arammaki/everflo_remote_control/test/everflo-sweep-2026-11-04-tak/bild_4L_2026-11-04T14-48-00.jpg

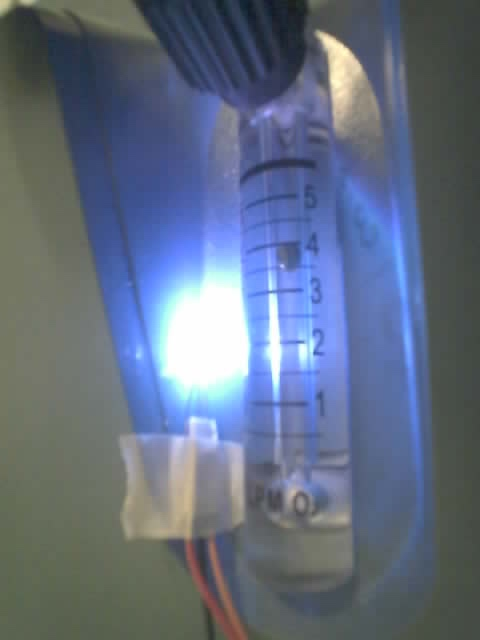
test/everflo-sweep-2026-11-04-tak/bild_4L_2026-11-04T14-48-00.jpg
