arammaki/everflo_remote_control/test/everflo-sweep-2026-11-04-dag/bild_5L_2026-11-04T14-58-03.jpg

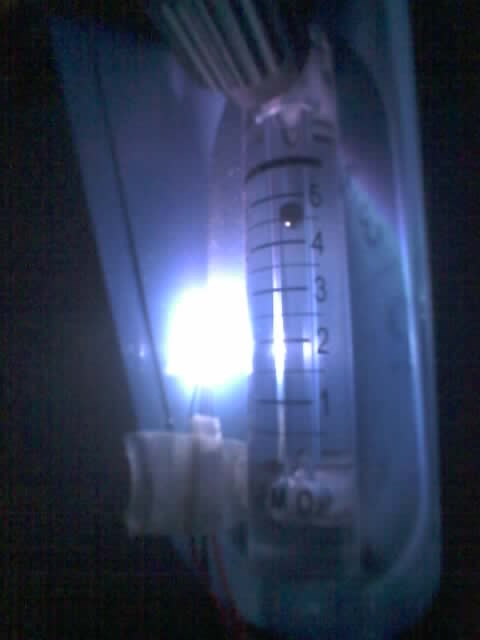
test/everflo-sweep-2026-11-04-dag/bild_5L_2026-11-04T14-58-03.jpg
