arammaki/everflo_remote_control/test/README.md

# Test images

Sets checked in opposite directions — a sweep must read, an old pose must be
refused. All run through the same harness so the two directions cannot drift apart:

```sh
node tools/validate_engine.mjs test/everflo-sweep-2026-10-05-hall
node tools/validate_engine.mjs test/everflo-sweep-2026-10-05-natt
node tools/validate_engine.mjs test/everflo-sweep-2026-10-05-rum
node tools/validate_engine.mjs test/everflo-sweep-2026-10-18-ljus
node tools/validate_engine.mjs test/everflo-sweep-2026-10-18-natt
node tools/validate_engine.mjs test/everflo-sweep-2026-10-18-ljus2
node tools/validate_engine.mjs test/everflo-sweep-2026-10-19-ljus
node tools/validate_engine.mjs test/everflo-sweep-2026-10-19-natt
node tools/validate_engine.mjs test/negative-everflo-2026-08-22 --expect-rejected
node tools/validate_engine.mjs test/negative-old-poses --expect-rejected
node tools/validate_engine.mjs test/platinum9-sweep-2026-09-30b
node tools/validate_engine.mjs test/platinum9-sweep-2026-09-30b-natt
node tools/validate_engine.mjs test/negative-platinum9-2026-09-30 --expect-rejected
node tools/validate_engine.mjs test/negative-platinum9-2026-09-29 --expect-rejected
node tools/validate_engine.mjs test/platinum9-kitchen-2026-09-29
node tools/validate_engine.mjs test/negative-platinum9-2026-09-26 --expect-rejected
```

Every directory carries a `PRESET` file naming the concentrator its frames
are of (`everflo` or `platinum9`). The harness reads it and refuses to
run without one: a sweep scored against the wrong machine's calibration is
refused wholesale, which looks exactly like an engine that has broken. A new
machine's sweep goes in its own directory with its own `PRESET`.

## `everflo-sweep-2026-10-05-hall/` — the care home's EverFlo calibration (history since 1.18.0)

13 frames, 2026-10-05 15:51–15:53 UTC, the EverFlo back on the unit with the
camera much closer to the tube than in the kitchen, the hall lamp on: the
resting ball, 0.5 to 5 in halves (read straight on), the top thick line
(`max`, reads 5.83 as a number) and one past it (`over_max`, must say Max).
`REF_PNG_EVERFLO_HALL`, the bands, `BASE_TILT` and `CAL` come from these;
`GEOMETRY.json` is the geometry they were measured with (calibrate.mjs
`--geometry`). Mean 0.012 L/min, worst 0.029; ambiguity 4.6x at worst (the
over-scale frame), registration 0.98.

## `everflo-sweep-2026-10-05-natt/` — the same pose in the dark

13 frames five minutes later, lamps off and curtains drawn: the 'natt'
reference. Not fitted to — the curve is the hall sweep's — so it checks the
curve independently: mean 0.016, worst 0.041. `over_max` is refused here
(ambiguity 2.5x) instead of called Max, listed in `ALLOW_REFUSED`.

## `everflo-sweep-2026-10-05-rum/` — the same pose, the room lamp on

13 frames at 16:01–16:03 UTC, hall lamp off, room lamp on: the 'rum'
reference. Not fitted to either: mean 0.024, worst 0.049, `over_max` says Max.

## `everflo-sweep-2026-10-18-ljus/` and `-natt/` — the camera's next pose

Taken by someone on site after the camera had moved ~11 px: the 'ljus' and
'natt2' references, aligned into the 10-05 coordinates ('ljus' dropped in
1.14.6; the light sweeps now read through ljus3). Not fitted to. The
bottom and top labels were corrected with the operator ("0" is 0.5, "0.5" is
0.75, "Övre max" a second max) — see each `LABELS.md`. No resting ball and no
ball past the top line in either. ljus mean 0.020 worst 0.046 (0.026 with 'ljus'); natt mean
0.025 worst 0.062.

## `everflo-sweep-2026-11-06-hagtorp-dag/` and `-mork/` — the EverFlo at Hagtorp (1.18.2-1.18.3)

Daylight with the lamps on, and lamps off with the blind down; they build
'hagtorp' and 'hagmork' on the Norrgården curve, both shifted (-3, +4) onto
'tak': means 0.041 and 0.056, worst 0.10 and 0.12. `over_max` may refuse.
The night there ('hagnatt', 1.18.4) has no sweep: it was built from uploads,
which stay out of the repo — see REF_PNG_EVERFLO_HAGNATT for the ids and the
checks. Forced onto `-mork/` it reads within 0.12 where it reads. The same goes
for the evening ('hagkväll', 1.18.5), forced onto `-dag/` within 0.11 from 1 to
4.5.

## `everflo-sweep-2026-11-04-tak/`, `-dag/` and `-natt/` — the EverFlo in force (Norrgården)

The EverFlo's calibration since 1.18.0. `-tak` (the ceiling lamp) carries the
curve: mean 0.039, worst 0.137 (0.5 L/min, the compressed bottom). `-dag` (the
lamp off, afternoon) has its own reference: mean 0.035. `-natt` (curtains
drawn) builds nothing and reads through the other two: mean 0.047 — the
independent check. `over_max` may refuse in all three (contrast on the
gate). Every older `everflo-sweep-2026-10-*` set (described above, as the care home's calibration) is a pose that is gone:
since 1.18.0 each frame may refuse (`ALLOW_REFUSED`), and all do.

## `visionaire5-sweep-2026-11-02b-hall/`, `-morker/` and `-hallrum/` — the VisionAire in force

The VisionAire's second calibration (1.16.0): the LED moved to the left of the
tube at 40, the camera moved with it. The curve is fitted to `-hall`;
validate_engine.mjs prints means 0.030 / 0.047 / 0.026 for `-hall`, `-morker`
and `-hallrum` (worst 0.063 / 0.096 / 0.035). Nothing refused. `LABELS.md` in each has the rest.

## `visionaire5-sweep-2026-11-02-ljus/`, `-morker/` and `-rum/` — the VisionAire's first light

Since 1.16.0 every frame here may be refused (`ALLOW_REFUSED`): that LED
position is gone. A frame that reads is still held to its label — the `-rum`
sweep reads 2, 2.5 and 3 within 0.09 from 33 px away. What follows is how they
were the calibration in force (1.15.x).

The VisionAire's calibration (1.15.0): a lit and a dark sweep minutes apart in
one pose, 1..4.75 in halves plus the resting ball. The curve is fitted to
`-ljus` (mean 0.024, worst 0.069); `-morker` is never fitted to and reads
within 0.18 (mean 0.066). `4.75_top` is the knob's end and must give the Max
state ("4,75 (max)"), not a number. `-rum/` (a second lamp lit, 1.15.1) reads
through its own shifted reference, mean 0.034, worst 0.15. Each directory's
`LABELS.md` has the rest.
Every other set here is refused when read as a VisionAire, and these three are
refused as EverFlo and as Platinum.

## `negative-everflo-2026-08-22/` — the kitchen calibration, refused since 1.14.1

Until 1.14.1 this was `sweep-2026-08-22/`, the calibration in force. The
camera pose it was taken in is gone, so like the other old poses it must now
be refused: all 23 are. What follows is its history as the calibration.

The 23 labelled frames the kitchen engine was built from: `REF_PNG`, the bands,
`BASE_TILT` and `CAL` all come from these. Taken 2026-08-22 20:06–20:14 under
the WS2812 at level 50 in a dark kitchen — the lighting the unit actually runs
in. The 21 frames carrying a number must read within 0.2 L/min of it.

They are here because the repo already contained everything *derived* from
them and nothing to derive it from. A recalibration is judged by comparing the
new sweep against this one, and `tools/validate_engine.mjs` had no data to run
against without them.

Two frames carry a state rather than a value. `0_min` is the ball against its
resting stop: it must produce a reading, and does so as "Under 0,3" — there is
no true value to compare against. `over_max` was taken deliberately past the
end of the printed scale and must come back as `Max` rather than as a number.
`5.7_max` despite its name is an ordinary labelled value, the top mark, and is
compared numerically: it reads 5.76 at y=154.4, four pixels below the Max
boundary at y=150.

## `negative-old-poses/` — 78 frames that must be refused

The sweeps from 2026-08-13, 08-15 and 08-16, from three camera poses that no
longer exist. Their labels were true when they were taken and are worthless
now, which is exactly what makes them useful: a frame from the wrong camera
pose must be **refused**, not read, and these are real frames rather than
synthetic ones. Measured 2026-09-05: all 78 refused. Registration runs
0.224–0.785 and two of them clear the 0.75 gate, but shift and spread catch
those.

**What this set does and does not prove.** Evaluate each gate on its own and
registration refuses 76 of the 78 and is the sole reason on 8; ambiguity
refuses 49 but is never the only gate refusing, and contrast never fires. So
the set constrains registration, and a change that loosened ambiguity would
pass it while being entirely untested. Do not read a green run here as
permission to touch that gate — `judge()` returns on the first gate that
fires, so its printed reason will happily say "ambiguity" for a frame the
shift gate was also refusing.

Do NOT run the plain harness over this directory — without `--expect-rejected`
it reports 78 failures, which is the correct answer to the wrong question.

This covers one case of the negative suite described in CLAUDE.md. Garbage
frames, occlusions, large shifts and wrong rotation are still uncovered, as is
the tolerance suite that says a 15 px shift, blur or a thin occluder must
still read about right. Those are constructible from the sweep above.

## `platinum9-sweep-2026-09-30b/` and `-natt/` — the Platinum 9's calibration

The fourth camera pose, at the care home. Day: 21 labelled frames, 14:21–14:26
local, the hall lamp on — the reference, the bands and the curve come from it.
Night: 20 frames, 14:27–14:30, the lamp off and the curtains drawn — its own
reference, shifted into the day one's coordinates, and never fitted to. Labels
up to 7 were read straight on; 0.5, 0.75 and 7.5 up are `<n>_approx`, held to
label − 1 .. label + tolerance.

Day 21/21, mean 0.094, worst 0.33; night 17/20, mean 0.093, worst 0.29. The
night sweep's resting ball, 0.5 and 1 L/min are refused at the calibrated
tilt (since `TILT_MARGIN`, 1.12.14) and listed in its `ALLOW_REFUSED` (since
1.13.0's references only the resting ball is, and the file lists only it:
19/20, mean 0.095) — a
file the harness reads: a listed label may be refused without failing the
sweep, anything else refused still fails it, and a listed frame that reads is
still held to its label. `TOLERANCE` is 0.35 in both for the half marks,
judged by eye between ticks (day 2.5 +0.33, night 6.5 −0.29); the whole marks
1..7 read within 0.12 (day) and 0.18 (night). `ALIGN_GEOMETRY.json` is the
geometry each reference was aligned with (see tools/align_reference.mjs).

Cross-checked 2026-09-30: both read as `everflo` are refused 41/41, and the
EverFlo sweep plus the 78 old poses read as `platinum9` are refused 101/101.

## `negative-platinum9-2026-09-30/` — the care home's morning pose, refused

The two sweeps of 2026-09-30 11:51–12:02 (day and dark), from the pose the
camera had before it was moved again at noon: 40 frames, all refused.

## `negative-platinum9-2026-09-29/` and `platinum9-kitchen-2026-09-29/`

The kitchen sweeps of 2026-09-29 (41 frames), from two poses 15–22 px and
24–29 px to the side of the care home's afternoon sweep. Split when the fourth
pose came, and re-split in 1.13.0.

`platinum9-kitchen-…` (24 frames, in the suite since 1.13.0) must READ, within
0.35 (`TOLERANCE`). It is the evidence behind `SHIFT_X` 30: with the sideways
gate at 20, 12 of these were refused by dx ALONE, and once allowed they read
2 → 2.02, 3 → 2.99, 4 → 4.01, 4.5 → 4.47, 7 → 6.99 through 'dag' — a 25 px
move and 8 px of dy, and the curve still holds on the whole marks. The half
marks (1.5 → 1.75, 2.5 → 2.76) are judged by eye, 8.5 and 9 from the side.
Six read through the 1.13.0 reference 'hall2' (1 → 0.86, 7.5, 8, 8.5, 9, max)
and one 8.5 through 'natt'. The largest |dx| that reads is 27.8, which is why
`SHIFT_X` was 30 and not more (38 since 1.14.9, the operator's call after an
EverFlo frame at 35.6 px — see `SHIFT_X` in `balldetector.js`). Mean 0.088, worst 0.26. Since 1.14.7 one frame
is refused, the 14:41 one at 4.5 (dx 16.7, not part of the SHIFT_X evidence),
listed by file name in `ALLOW_REFUSED`; mean 0.092 over the 15 that read.

`negative-…` (17 frames) stays `--expect-rejected`: all 17 are refused by
ambiguity (1.1–2.97x), registration 0.78–0.86 above its gate; eight of them
(dx 25–30) were also refused by dx before 1.13.0. These are a pose that reads
RIGHT where it reads, so the set guards the ambiguity gate conservatively
rather than proving the refusals necessary. Nothing in the suite constrains
a sideways move between 30 px and the 40 px search edge — and since 1.14.9 a
slide of 30-38 px passes the dx gate, which then refuses only 38-40:
`negative-old-poses/` saturates at 40, and the EverFlo slide of 34 px that
read 1.73 for 2.0 (2026-08-16) is not in it.

## `negative-platinum9-2026-09-26/` — the Platinum's first pose, refused

The first Platinum sweep (2026-09-26 21:31–21:35 UTC, night, WS2812 plus the
ceiling lamp). The camera has been moved since, so like `negative-old-poses/`
it is run with `--expect-rejected`: all 21 refused. Registration against the
current references reaches 0.52 at best (it reached 0.72 against the
morning pose's, 2026-09-30).
