arammaki/everflo_remote_control/test/everflo-sweep-2026-11-06-hagtorp-dag/LABELS.md

The EverFlo back at Hagtorp, daylight with the lamps on, 2026-11-06 11:28-11:30 UTC (1.18.2). LED at 50. Labels as sent, except "0" renamed `0_min`. Reference 'hagtorp' is the median of these frames, aligned twice against the sweep's own median and shifted (-3, +4) onto 'tak' — the shift chosen by these labels (the curve is Norrgården's 'tak' curve, kept). `over_max` may refuse (contrast 0.08).
