arammaki/everflo_remote_control/test/everflo-sweep-2026-11-04-dag/LABELS.md

The EverFlo at Norrgården, the ceiling lamp off in afternoon daylight, 2026-11-04 14:54-14:58 UTC, minutes after `-tak` (1.18.0). LED at 50. Same renames: `0_min` (the resting ball). `over_max` may refuse (contrast at the gate). Reference 'dag' is the median of these frames, aligned twice against the sweep's own median and shifted (+2.8, -1.5) onto 'tak'. Never fitted to: it checks the curve fitted to `-tak`.
