arammaki/everflo_remote_control/test/everflo-sweep-2026-11-04-natt/LABELS.md

The EverFlo at Norrgården, the ceiling lamp off with the room as dark as it gets by day (curtains drawn), 2026-11-04 15:00-15:02 UTC, after `-tak` and `-dag` (1.18.0). LED at 50. Same renames: `0_min`. NOT used to build anything: no reference comes from it. It reads through 'tak' and 'dag' at registration 0.98-0.99, mean 0.047, worst 0.136 — an independent check of both the curve and the references. A reference of its own was tried and did not help (0.041-0.079 depending on a shift that the ticks and edges could not pin down). `over_max` may refuse (contrast at the gate).
