arammaki/everflo_remote_control/test/everflo-sweep-2026-11-04-tak/LABELS.md

The EverFlo at Norrgården, the ceiling lamp on, 2026-11-04 14:46-14:48 UTC, the first sweep of this place (1.18.0). LED at 50, left of the tube. Labels as sent, except "0" renamed `0_min` (the resting ball, "Under 0,5"). `max` is the ball against the top line from below (reads 5.82, extrapolated); `over_max` is on it (Max — or refused: its contrast is 0.10, on the gate, so it is in ALLOW_REFUSED). Reference 'tak' is the median of these frames, aligned twice against the sweep's own median; the curve is fitted to these labels with 1 L/min weighted 4x.
