arammaki/everflo_remote_control/test/visionaire5-sweep-2026-11-02-ljus/LABELS.md

Light sweep of the AirSep VisionAire 5 (the room lit), 2026-11-02 21:09-21:11 UTC, the first sweep of this machine; the resting frame was taken last, at 21:18, after `-morker`. Labels as sent, except "0" renamed `0_min` (the resting ball; "Under 0,5") and "4.75" renamed `4.75_top`: the knob's end, which this preset reports as its Max state ("4,75 (max)"), so validate_engine.mjs requires Max there rather than a number. The camera moves with the knob (dx -2 .. +5 px, dy +2 .. -4 from 1 L/min to the top; the resting frame +7). Reference 'ljus' is the median of these frames, aligned twice against the sweep's own median; the curve is fitted to these labels. Those references were removed in 1.16.0, when the LED moved; this sweep stays with every frame allowed to refuse (ALLOW_REFUSED).
