arammaki/everflo_remote_control/test/visionaire5-sweep-2026-11-02-morker/LABELS.md

Dark sweep of the AirSep VisionAire 5 (lamps off, the WS2812 alone), 2026-11-02 21:13-21:15 UTC, between the light sweep and its resting frame. Same renames as `-ljus`: `0_min` (the resting ball) and `4.75_top` (the knob's end, the Max state). Below 2.5 L/min the ball shows as little more than a glint. Reference 'natt' is the median of these frames, aligned twice against the sweep's own median and not shifted onto 'ljus'. Never fitted to: it checks the light curve independently (mean 0.066, worst 0.18 at 4, where the ball stands ~10 px higher than in the light sweep's 4 — the knob set a little differently in the dark). Those references were removed in 1.16.0, when the LED moved; this sweep stays with every frame allowed to refuse (ALLOW_REFUSED).
