arammaki/everflo_remote_control/test/visionaire5-sweep-2026-11-02-rum/LABELS.md

The AirSep VisionAire 5 with the room lit as for `-ljus` plus a second lamp, 2026-11-02 21:58-22:03 UTC, after 1.15.0 landed. Labels as sent, except "0" renamed `0_min` (the resting ball) and "4.75" renamed `4.75_top` (the knob's end, the Max state). The 3.25 frame's ball stands where the 3.5 frame's does (it reads 3.40, inside the tolerance); the label is likely off. The camera had moved ~16 px sideways and 4-5 px up since `-ljus`. Reference 'rum' is the median of these frames, aligned twice against the sweep's own median and shifted (+16.4, -4.4) into 'ljus''s coordinates — see the comment at REF_PNG_VISIONAIRE5_RUM. Those references were removed in 1.16.0, when the LED moved; this sweep stays with every frame allowed to refuse (ALLOW_REFUSED).
