arammaki/everflo_remote_control/test/visionaire5-sweep-2026-11-02b-hall/LABELS.md

The AirSep VisionAire 5's second calibration (1.16.0): the LED moved to the left of the tube and set to 40, the hall lamp on, 2026-11-02 23:05-23:07 UTC. Labels as sent, except "0" renamed `0_min` (the resting ball, "Under 0,5") and "4.75" renamed `4.75_top` (the knob's end, the Max state "4,75 (max)"). Reference 'hall' is the median of these frames, aligned twice against the sweep's own median; the curve is fitted to these labels, 4.75 included.
