arammaki/everflo_remote_control/test/visionaire5-sweep-2026-11-02b-hallrum/LABELS.md

The hall and room lamps on, the VisionAire's second calibration (1.16.0, the LED left of the tube at 40), 2026-11-02 23:08-23:09 UTC, just after `-hall`. Same renames: `0_min`, `4.75_top`. The camera slid ~6 px sideways mid-sweep (from 2 to 3 L/min). Reference 'rum' is the median of these frames, aligned twice against the sweep's own median and shifted (+4.8, -0.45) onto 'hall'. Never fitted to: mean 0.026 over the eight numeric labels, worst 0.035.
