arammaki/everflo_remote_control/test/visionaire5-sweep-2026-11-02b-morker/LABELS.md

Dark sweep of the VisionAire's second calibration (1.16.0, the LED left of the tube at 40), 2026-11-02 23:03-23:05 UTC, just before `-hall`. Same renames: `0_min`, `4.75_top`. Reference 'natt' is the median of these frames, aligned twice against the sweep's own median, not shifted (its ticks and edges sit within 0.4 px of 'hall''s). Never fitted to: mean 0.047 over the eight numeric labels, worst 0.096.
