arammaki/everflo_remote_control/test/everflo-sweep-2026-10-19-ljus/LABELS.md

Light sweep in the 2026-10-19 pose, 07:50-07:52 UTC, after the camera was screwed down tighter (it had been knocked that morning). Labels as sent, except "0" renamed `0_min` (the resting ball; it says "Under 0,3"). `max` is the ball touching the top line from below (reads 5.84, extrapolated), `over_max` the ball on the line (Max). Reference 'ljus3' is the median of these frames, aligned twice (against 'ljus', then its own first pass), so it is in the 10-05 coordinates.
