arammaki/everflo_remote_control/test/everflo-sweep-2026-10-19-natt/LABELS.md

Dark sweep in the 2026-10-19 pose (curtains drawn, daytime — as dark as the room gets by day), 07:54-07:56 UTC, two minutes after `-10-19-ljus`. The camera did not move between them: the printed ticks of each pair of frames agree within 0.2 px. Labels as sent, except "0" renamed `0_min` (the resting ball; "Under 0,3"). `max` touches the top line from below (5.88, extrapolated), `over_max` is on it (Max). Reference 'natt3' is the median of these frames, aligned against 'natt2' then its own first pass, and shifted -1.7 px vertically so its ticks in the ball band match 'ljus3' — see the comment at REF_PNG_EVERFLO_NATT3.
