arammaki/everflo_remote_control/test/everflo-sweep-2026-10-18-natt/LABELS.md

Relabelled after the pictures and the operator: the frame named "0" is 0.5 (the knob at its lowest, machine on) and the one named "0.5" is 0.75. Both frames named max are the operator's: "Max" has the ball about 0.4 L/min below the top thick line (reads ~5.4), "Övre max" has it touching the line from below (reads ~5.8) — neither is past the line, so the harness only asks that they read. In the 10-05 sweeps `max` is the ball AT the line. No frame of the resting ball and none past the top line in this sweep.

Added the same evening (15:42 UTC, sent separately): a resting ball (`0_min`, says "Under 0,3" at ambiguity 3.5x — the thinnest margin in this sweep) and a 0.5 L/min frame (reads 0.50).
