arammaki/everflo_remote_control/test/everflo-sweep-2026-10-05-hall/bild_0.5L_2026-10-05T15-51-44.jpg

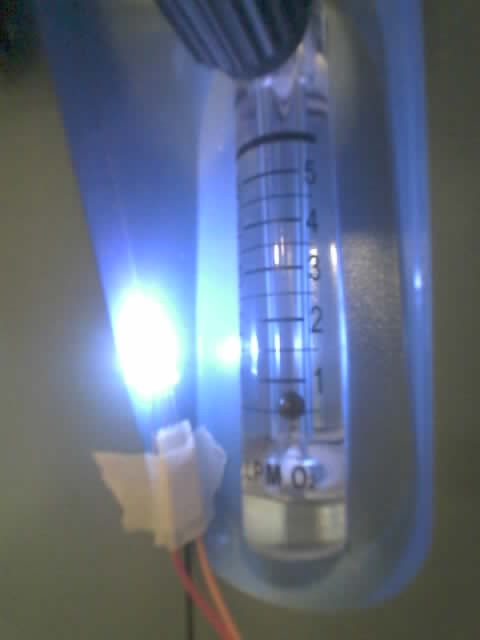
test/everflo-sweep-2026-10-05-hall/bild_0.5L_2026-10-05T15-51-44.jpg
