arammaki/everflo_remote_control/test/everflo-sweep-2026-10-05-hall/bild_5L_2026-10-05T15-53-10.jpg

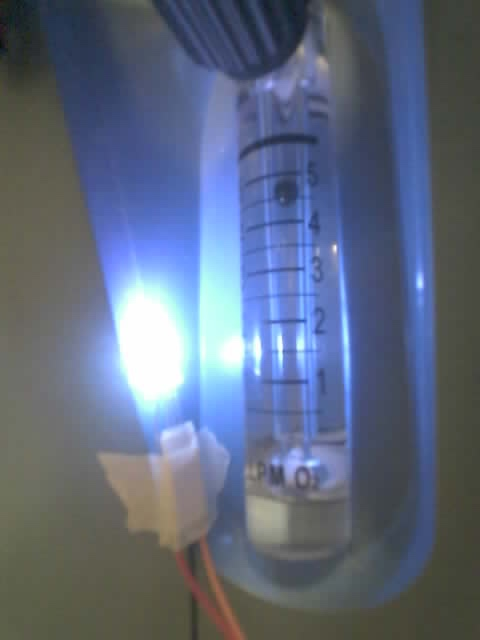
test/everflo-sweep-2026-10-05-hall/bild_5L_2026-10-05T15-53-10.jpg
