arammaki/everflo_remote_control/test/everflo-sweep-2026-10-05-natt/bild_0.5L_2026-10-05T15-56-34.jpg

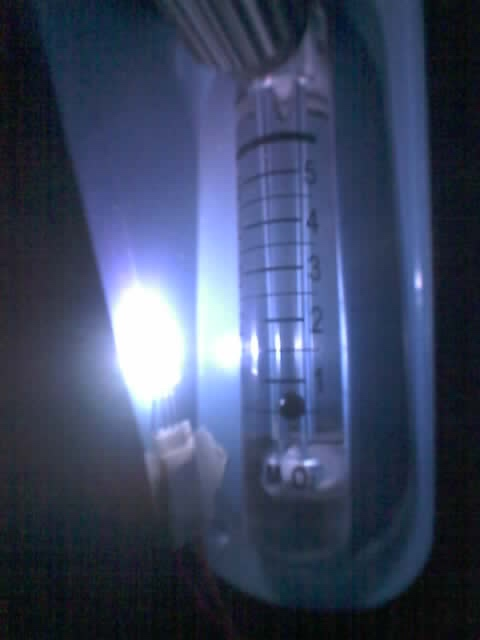
test/everflo-sweep-2026-10-05-natt/bild_0.5L_2026-10-05T15-56-34.jpg
