arammaki/everflo_remote_control/test/everflo-sweep-2026-10-05-rum/bild_2L_2026-10-05T16-01-54.jpg

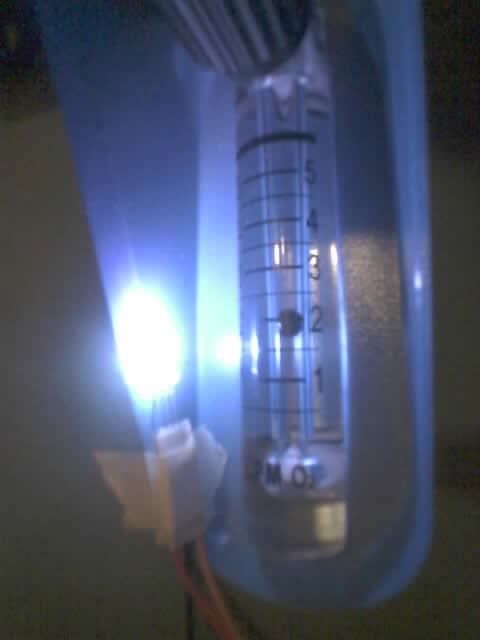
test/everflo-sweep-2026-10-05-rum/bild_2L_2026-10-05T16-01-54.jpg
