arammaki/everflo_remote_control/test/everflo-sweep-2026-10-05-rum/bild_maxL_2026-10-05T16-03-06.jpg

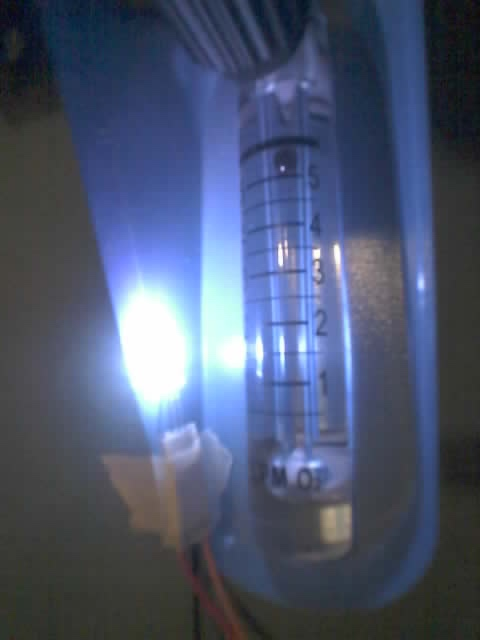
test/everflo-sweep-2026-10-05-rum/bild_maxL_2026-10-05T16-03-06.jpg
