arammaki/everflo_remote_control/test/everflo-sweep-2026-10-18-ljus2/bild_0_minL_2026-10-18T15-47-32.jpg

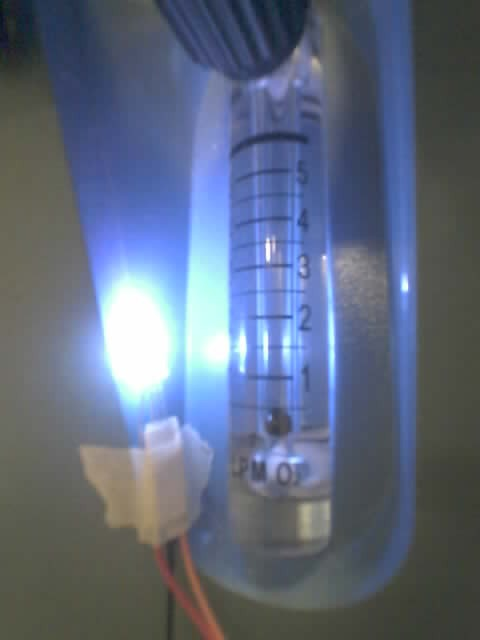
test/everflo-sweep-2026-10-18-ljus2/bild_0_minL_2026-10-18T15-47-32.jpg
