arammaki/everflo_remote_control/test/everflo-sweep-2026-10-18-ljus2/bild_4.5L_2026-10-18T15-48-23.jpg

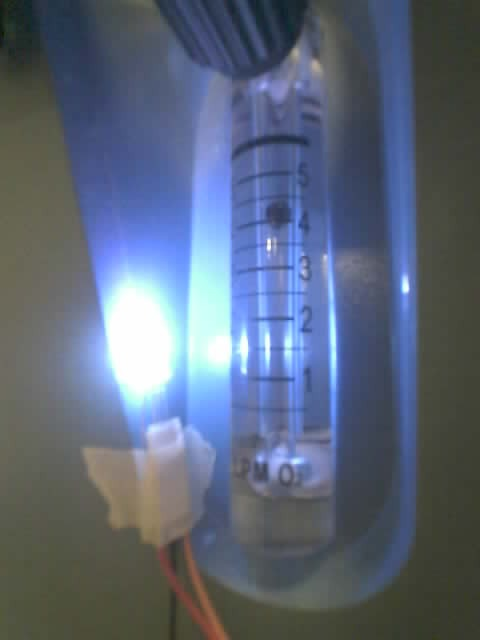
test/everflo-sweep-2026-10-18-ljus2/bild_4.5L_2026-10-18T15-48-23.jpg
