arammaki/everflo_remote_control/test/everflo-sweep-2026-10-18-ljus/bild_0.75L_2026-10-18T15-01-19.jpg

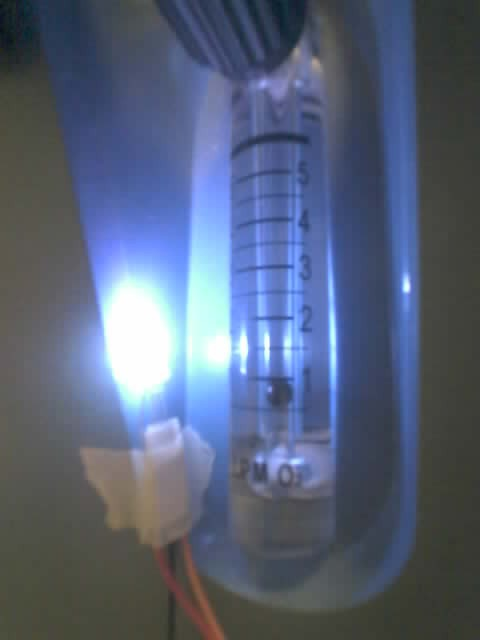
test/everflo-sweep-2026-10-18-ljus/bild_0.75L_2026-10-18T15-01-19.jpg
