arammaki/everflo_remote_control/test/everflo-sweep-2026-10-18-ljus/bild_1L_2026-10-18T15-01-25.jpg

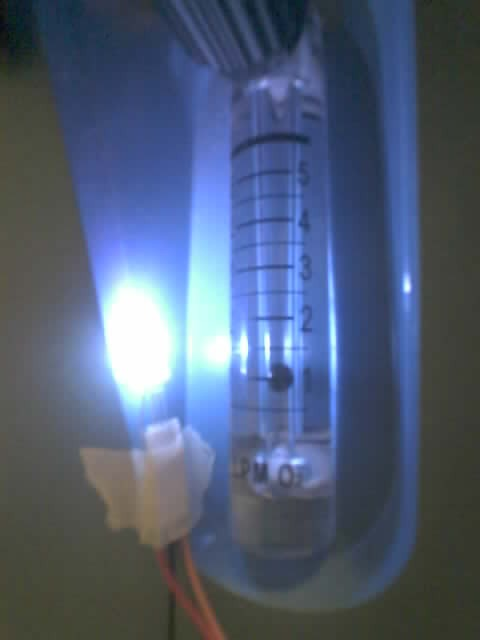
test/everflo-sweep-2026-10-18-ljus/bild_1L_2026-10-18T15-01-25.jpg
