arammaki/everflo_remote_control/test/everflo-sweep-2026-10-18-natt/bild_0.5L_2026-10-18T14-56-23.jpg

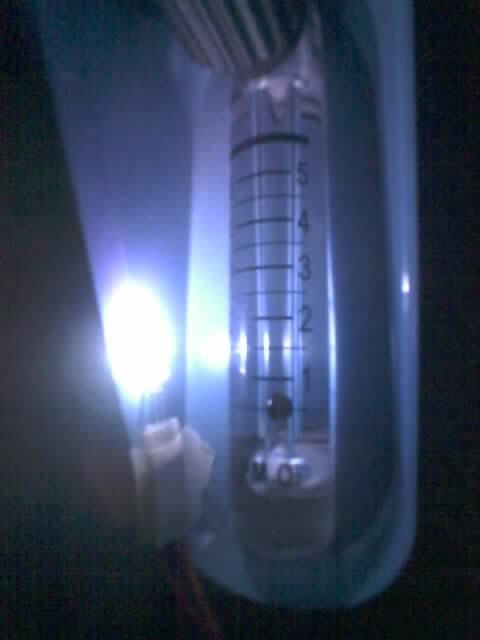
test/everflo-sweep-2026-10-18-natt/bild_0.5L_2026-10-18T14-56-23.jpg
