arammaki/everflo_remote_control/test/everflo-sweep-2026-10-19-ljus/bild_0_minL_2026-10-19T07-50-25.jpg

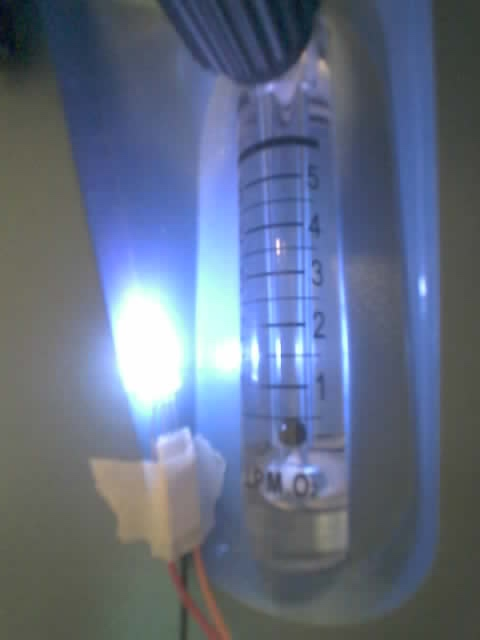
test/everflo-sweep-2026-10-19-ljus/bild_0_minL_2026-10-19T07-50-25.jpg
