arammaki/everflo_remote_control/test/everflo-sweep-2026-10-19-ljus/bild_5L_2026-10-19T07-51-53.jpg

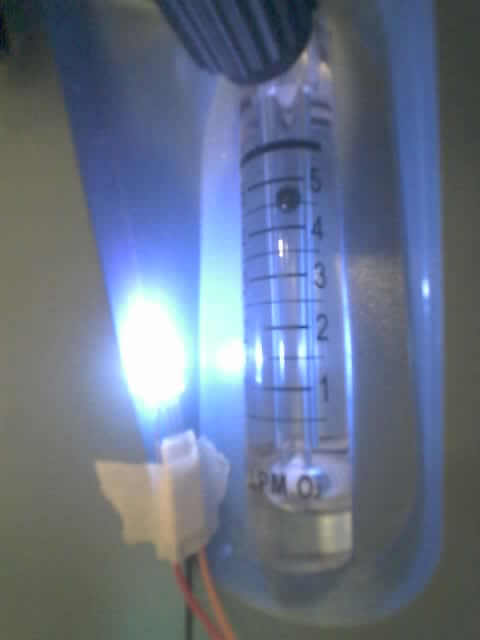
test/everflo-sweep-2026-10-19-ljus/bild_5L_2026-10-19T07-51-53.jpg
