arammaki/everflo_remote_control/test/everflo-sweep-2026-10-19-natt/bild_0.5L_2026-10-19T07-54-29.jpg

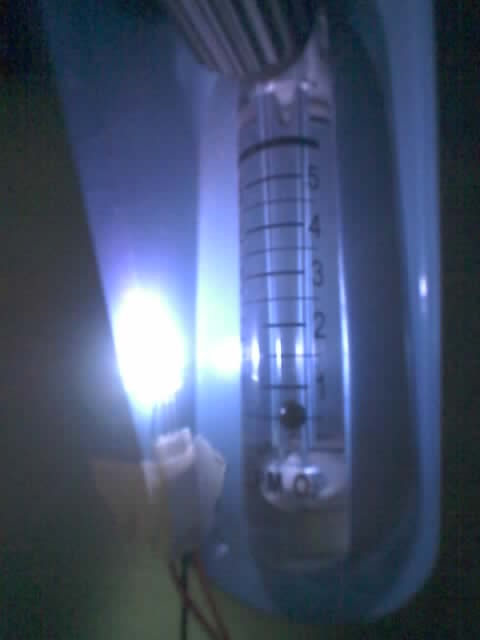
test/everflo-sweep-2026-10-19-natt/bild_0.5L_2026-10-19T07-54-29.jpg
