arammaki/everflo_remote_control/test/everflo-sweep-2026-10-19-natt/bild_4L_2026-10-19T07-55-20.jpg

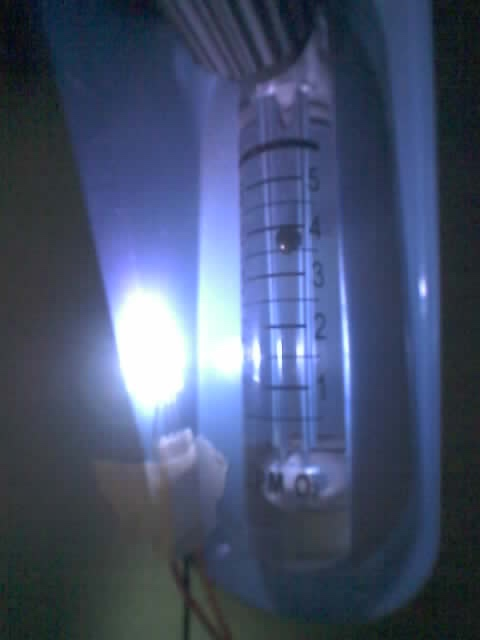
test/everflo-sweep-2026-10-19-natt/bild_4L_2026-10-19T07-55-20.jpg
