arammaki/everflo_remote_control/test/everflo-sweep-2026-11-04-natt/bild_0_minL_2026-11-04T15-00-46.jpg

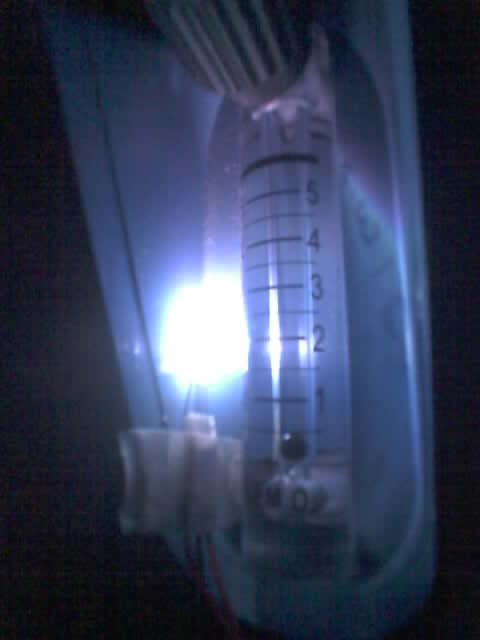
test/everflo-sweep-2026-11-04-natt/bild_0_minL_2026-11-04T15-00-46.jpg
