arammaki/everflo_remote_control/test/everflo-sweep-2026-11-04-tak/bild_0_minL_2026-11-04T14-46-55.jpg

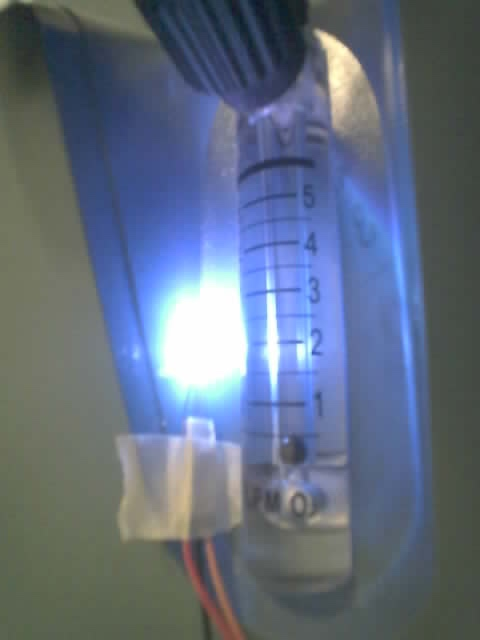
test/everflo-sweep-2026-11-04-tak/bild_0_minL_2026-11-04T14-46-55.jpg
