arammaki/everflo_remote_control/test/everflo-sweep-2026-11-04-tak/bild_maxL_2026-11-04T14-48-38.jpg

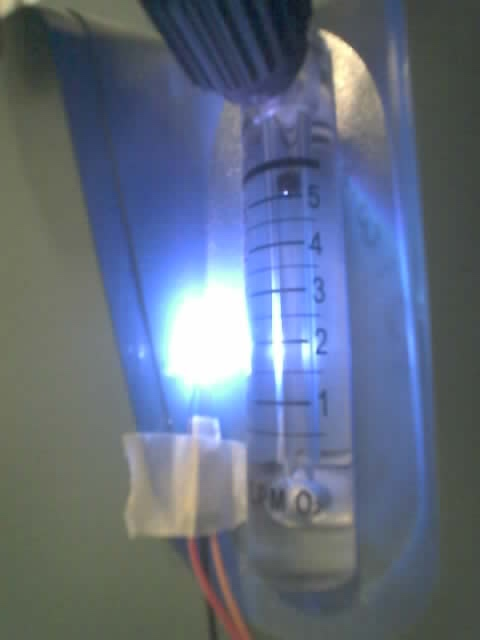
test/everflo-sweep-2026-11-04-tak/bild_maxL_2026-11-04T14-48-38.jpg
