arammaki/everflo_remote_control/test/everflo-sweep-2026-11-06-hagtorp-dag/bild_0.5L_2026-11-06T11-28-19.jpg

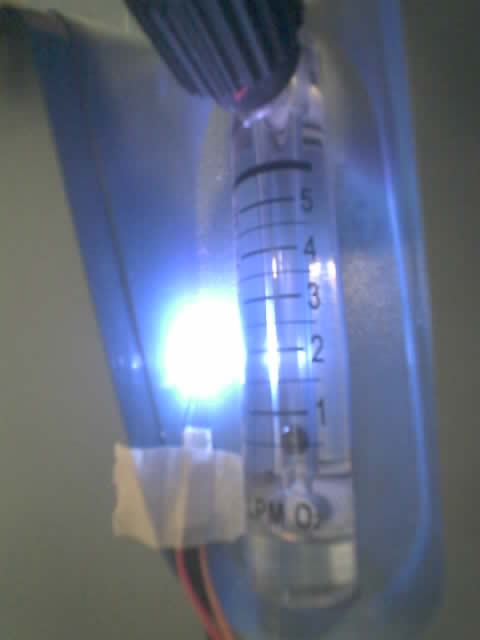
test/everflo-sweep-2026-11-06-hagtorp-dag/bild_0.5L_2026-11-06T11-28-19.jpg
