arammaki/everflo_remote_control/test/everflo-sweep-2026-11-06-hagtorp-dag/bild_3L_2026-11-06T11-29-03.jpg

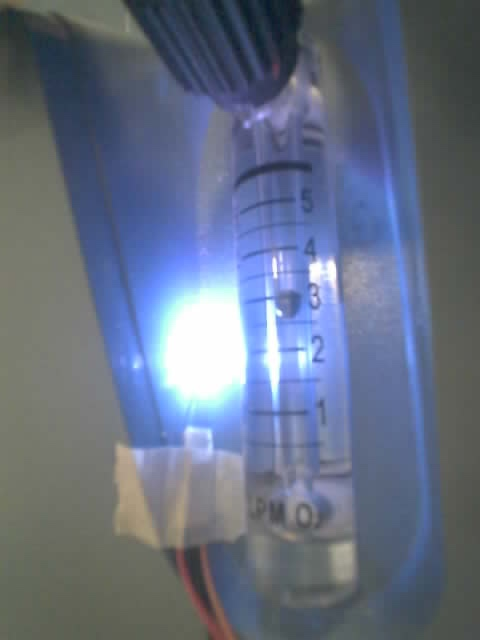
test/everflo-sweep-2026-11-06-hagtorp-dag/bild_3L_2026-11-06T11-29-03.jpg
