arammaki/everflo_remote_control/test/everflo-sweep-2026-11-06-hagtorp-mork/bild_4.5L_2026-11-06T12-06-07.jpg

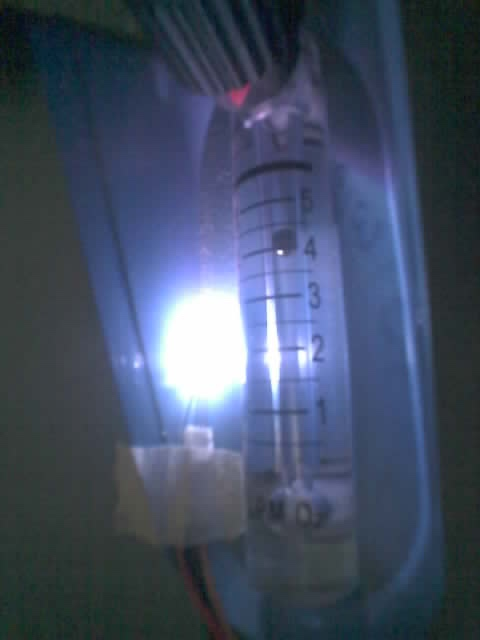
test/everflo-sweep-2026-11-06-hagtorp-mork/bild_4.5L_2026-11-06T12-06-07.jpg
