arammaki/everflo_remote_control/test/negative-everflo-2026-08-22/bild_1.5L_2026-08-22T20-09-46.jpg

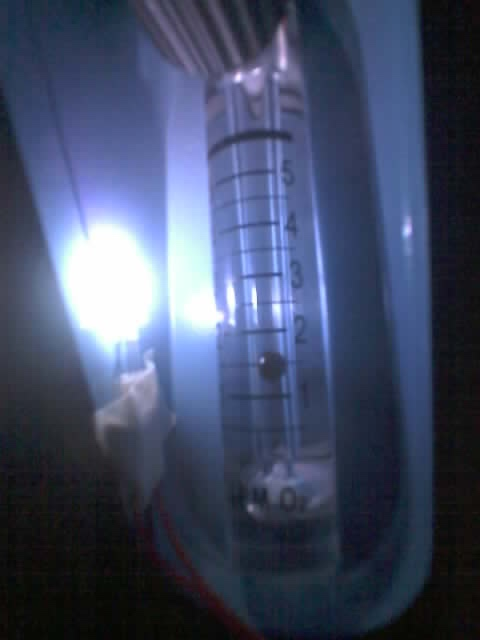
test/negative-everflo-2026-08-22/bild_1.5L_2026-08-22T20-09-46.jpg
