arammaki/everflo_remote_control/test/negative-platinum9-2026-09-26/bild_0.5_approxL_2026-09-26T21-31-37.jpg

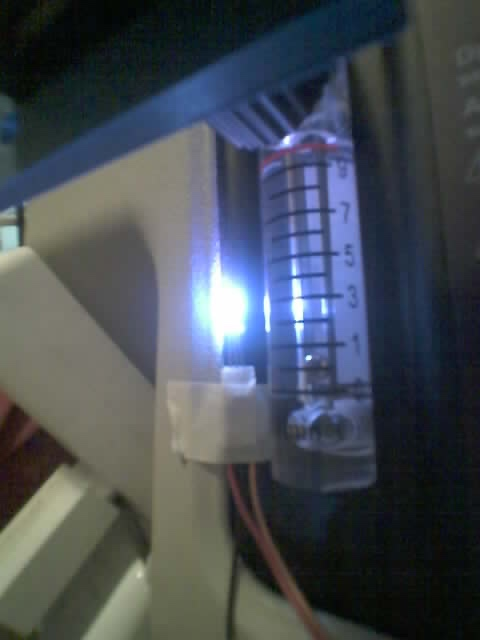
test/negative-platinum9-2026-09-26/bild_0.5_approxL_2026-09-26T21-31-37.jpg
