arammaki/everflo_remote_control/test/negative-platinum9-2026-09-29/bild_0.5_approxL_2026-09-29T14-40-02.jpg

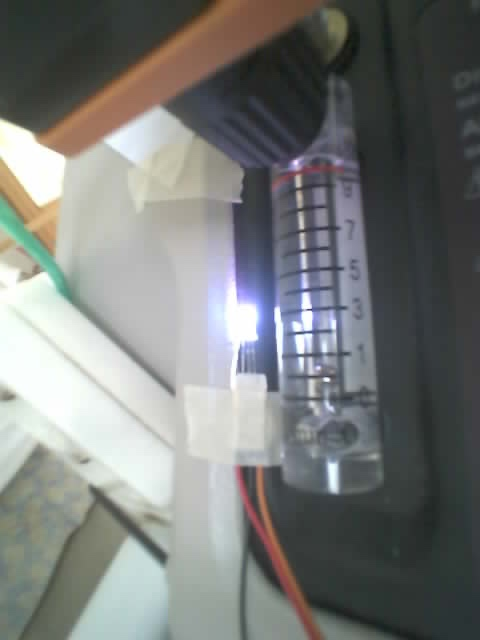
test/negative-platinum9-2026-09-29/bild_0.5_approxL_2026-09-29T14-40-02.jpg
