arammaki/everflo_remote_control/test/negative-platinum9-2026-09-29/bild_2.5L_2026-09-29T14-41-04.jpg

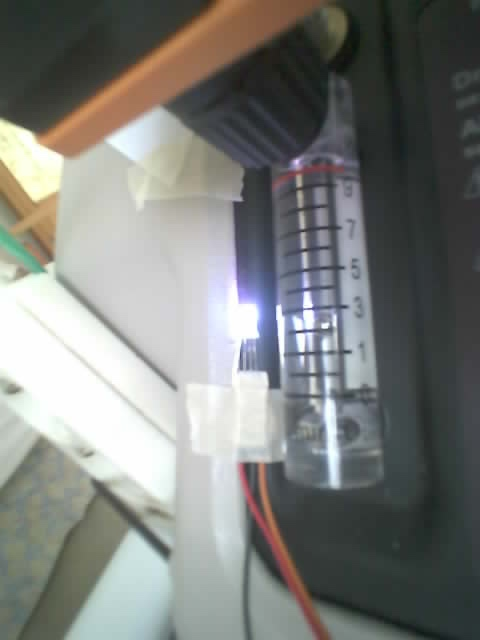
test/negative-platinum9-2026-09-29/bild_2.5L_2026-09-29T14-41-04.jpg
