arammaki/everflo_remote_control/test/negative-platinum9-2026-09-29/bild_2L_2026-09-29T14-40-52.jpg

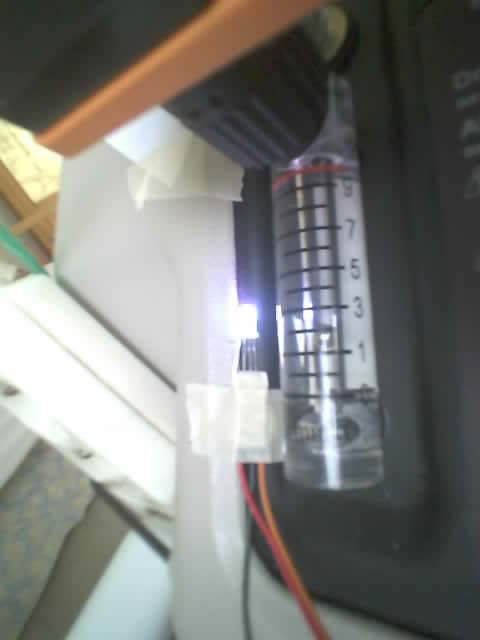
test/negative-platinum9-2026-09-29/bild_2L_2026-09-29T14-40-52.jpg
