arammaki/everflo_remote_control/test/negative-platinum9-2026-09-29/bild_3.5L_2026-09-29T15-49-20.jpg

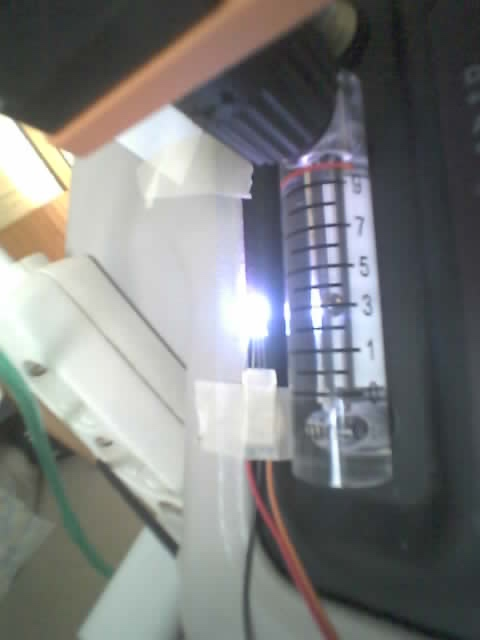
test/negative-platinum9-2026-09-29/bild_3.5L_2026-09-29T15-49-20.jpg
