arammaki/everflo_remote_control/test/negative-platinum9-2026-09-29/bild_5L_2026-09-29T14-42-11.jpg

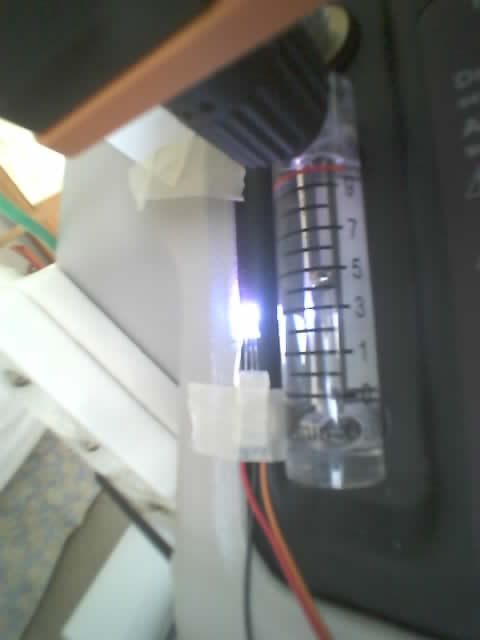
test/negative-platinum9-2026-09-29/bild_5L_2026-09-29T14-42-11.jpg
