arammaki/everflo_remote_control/test/negative-platinum9-2026-09-29/bild_maxL_2026-09-29T15-52-53.jpg

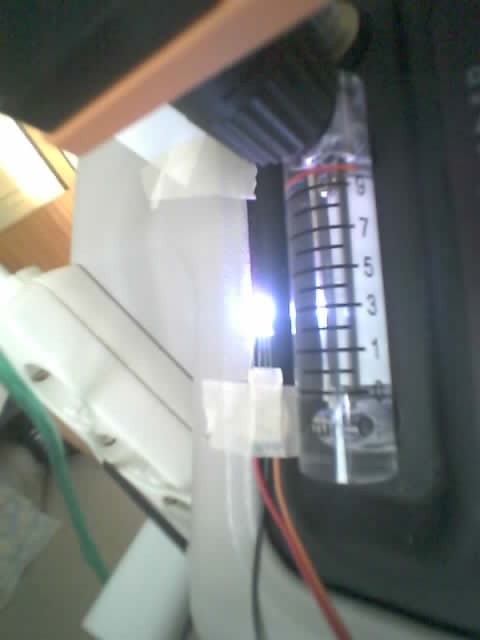
test/negative-platinum9-2026-09-29/bild_maxL_2026-09-29T15-52-53.jpg
