arammaki/everflo_remote_control/test/negative-platinum9-2026-09-30/bild_0.5_approxL_2026-09-30T09-58-21.jpg

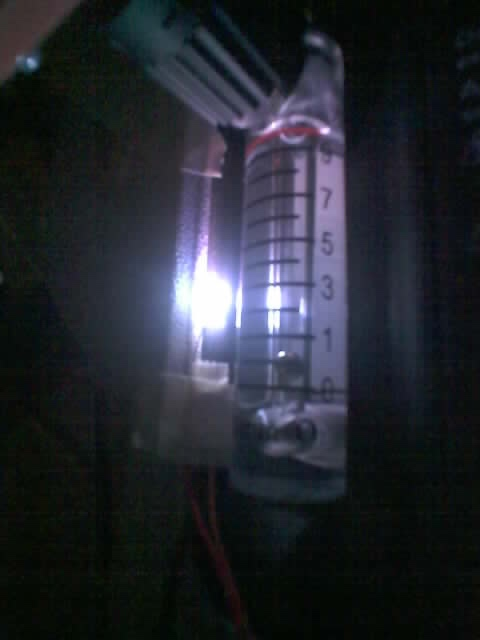
test/negative-platinum9-2026-09-30/bild_0.5_approxL_2026-09-30T09-58-21.jpg
