arammaki/everflo_remote_control/test/negative-platinum9-2026-09-30/bild_0_minL_2026-09-30T09-51-30.jpg

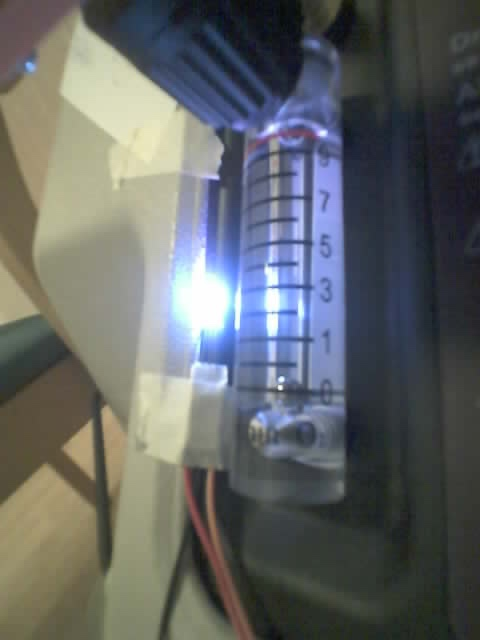
test/negative-platinum9-2026-09-30/bild_0_minL_2026-09-30T09-51-30.jpg
