arammaki/everflo_remote_control/test/negative-platinum9-2026-09-30/bild_2.5L_2026-09-30T09-59-00.jpg

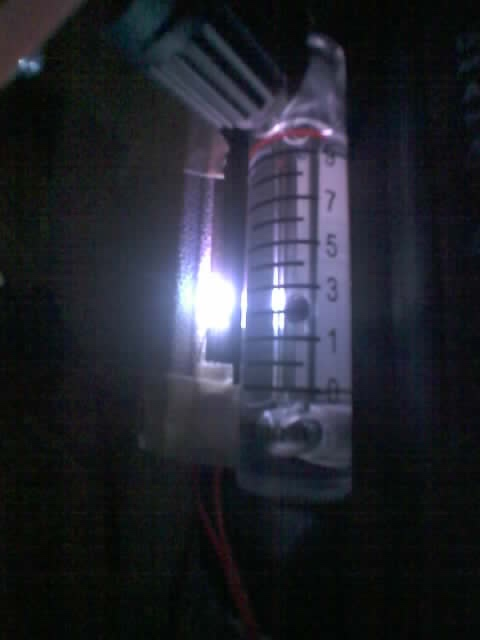
test/negative-platinum9-2026-09-30/bild_2.5L_2026-09-30T09-59-00.jpg
