arammaki/everflo_remote_control/test/negative-platinum9-2026-09-30/bild_2L_2026-09-30T09-58-50.jpg

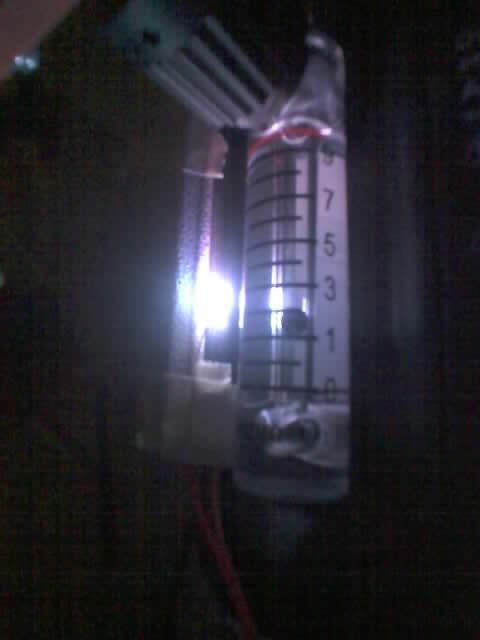
test/negative-platinum9-2026-09-30/bild_2L_2026-09-30T09-58-50.jpg
