arammaki/everflo_remote_control/test/negative-platinum9-2026-09-30/bild_3.5L_2026-09-30T09-59-18.jpg

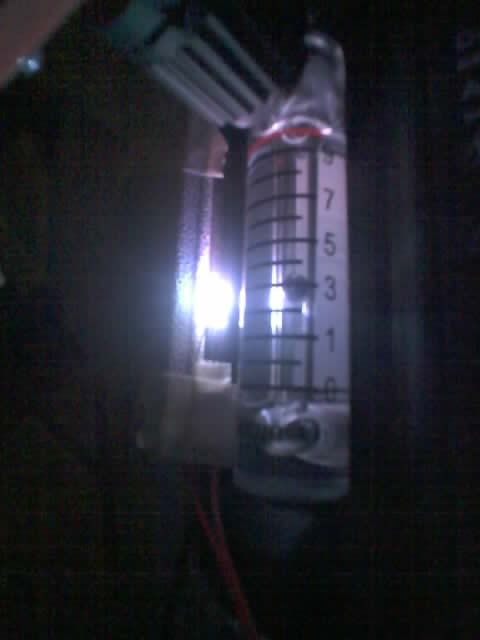
test/negative-platinum9-2026-09-30/bild_3.5L_2026-09-30T09-59-18.jpg
