arammaki/everflo_remote_control/test/negative-platinum9-2026-09-30/bild_6L_2026-09-30T10-00-04.jpg

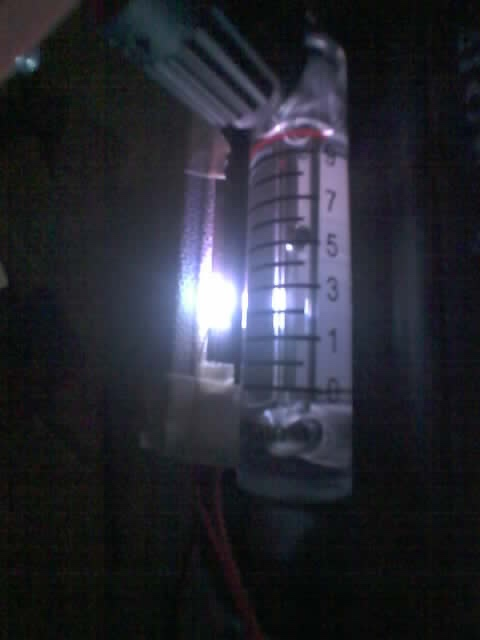
test/negative-platinum9-2026-09-30/bild_6L_2026-09-30T10-00-04.jpg
