arammaki/everflo_remote_control/test/negative-platinum9-2026-09-30/bild_8_approxL_2026-09-30T09-54-27.jpg

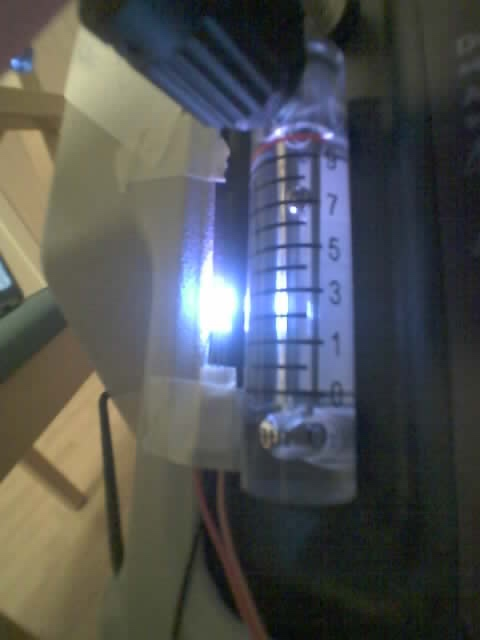
test/negative-platinum9-2026-09-30/bild_8_approxL_2026-09-30T09-54-27.jpg
