arammaki/everflo_remote_control/test/negative-platinum9-2026-09-30/bild_9_approxL_2026-09-30T09-54-57.jpg

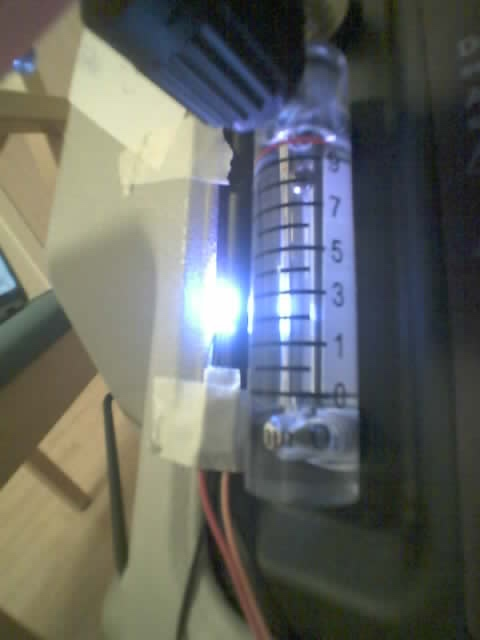
test/negative-platinum9-2026-09-30/bild_9_approxL_2026-09-30T09-54-57.jpg
