arammaki/everflo_remote_control/test/platinum9-kitchen-2026-09-29/bild_4L_2026-09-29T14-41-42.jpg

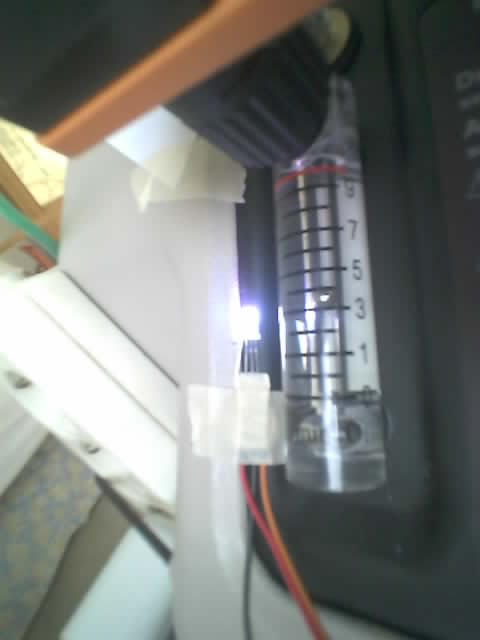
test/platinum9-kitchen-2026-09-29/bild_4L_2026-09-29T14-41-42.jpg
