arammaki/everflo_remote_control/test/platinum9-sweep-2026-09-30b-natt/bild_0_minL_2026-09-30T12-27-18.jpg

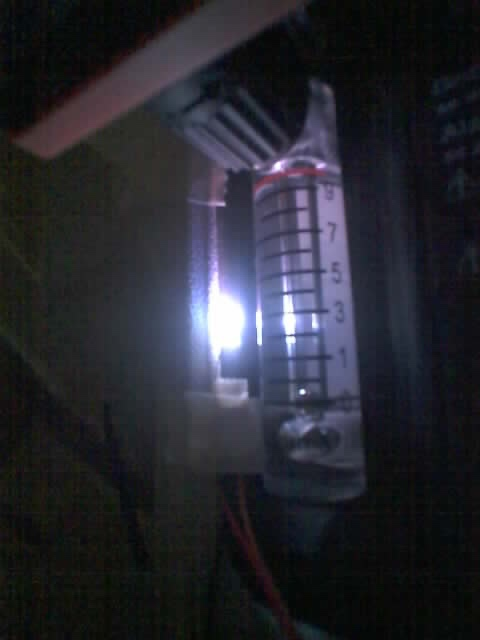
test/platinum9-sweep-2026-09-30b-natt/bild_0_minL_2026-09-30T12-27-18.jpg
