arammaki/everflo_remote_control/test/platinum9-sweep-2026-09-30b-natt/bild_1.5L_2026-09-30T12-27-38.jpg

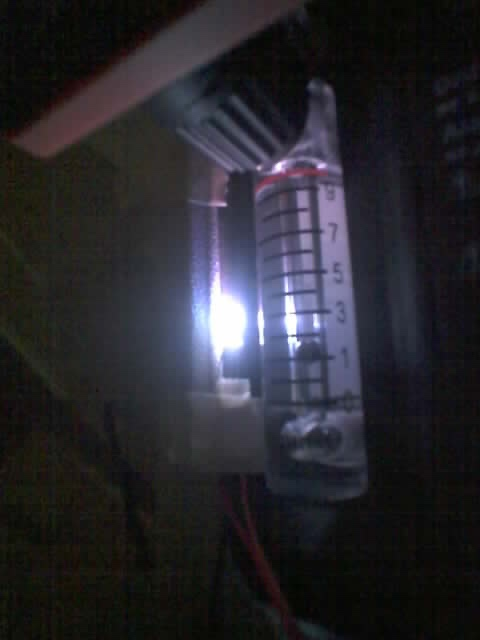
test/platinum9-sweep-2026-09-30b-natt/bild_1.5L_2026-09-30T12-27-38.jpg
