arammaki/everflo_remote_control/test/platinum9-sweep-2026-09-30b-natt/bild_6.5L_2026-09-30T12-28-43.jpg

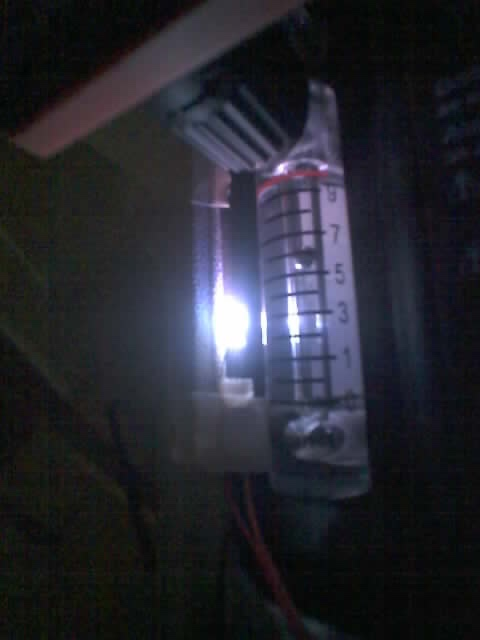
test/platinum9-sweep-2026-09-30b-natt/bild_6.5L_2026-09-30T12-28-43.jpg
