arammaki/everflo_remote_control/test/platinum9-sweep-2026-09-30b/bild_0.5_approxL_2026-09-30T12-21-18.jpg

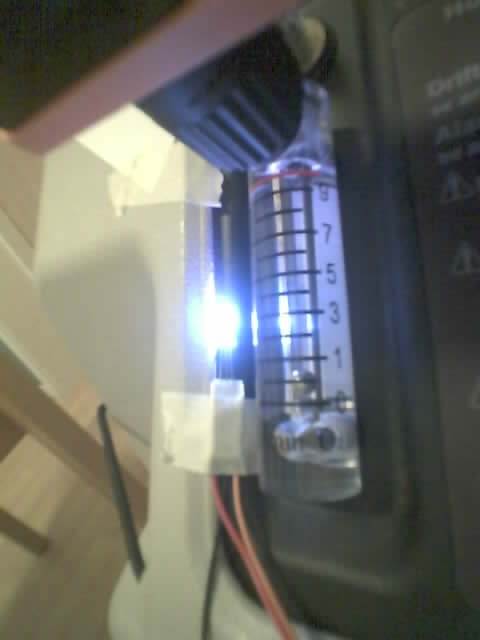
test/platinum9-sweep-2026-09-30b/bild_0.5_approxL_2026-09-30T12-21-18.jpg
