arammaki/everflo_remote_control/test/platinum9-sweep-2026-09-30b/bild_2.5L_2026-09-30T12-22-14.jpg

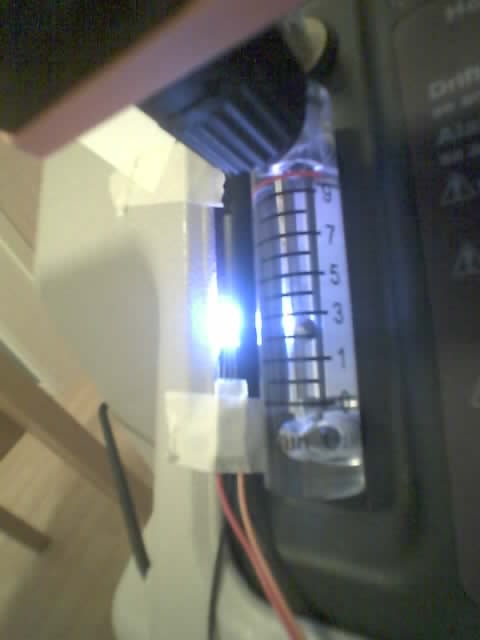
test/platinum9-sweep-2026-09-30b/bild_2.5L_2026-09-30T12-22-14.jpg
