arammaki/everflo_remote_control/test/platinum9-sweep-2026-09-30b/bild_6.5L_2026-09-30T12-24-23.jpg

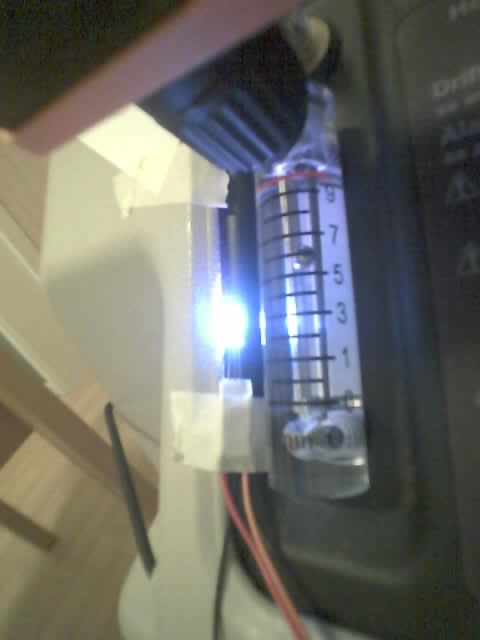
test/platinum9-sweep-2026-09-30b/bild_6.5L_2026-09-30T12-24-23.jpg
