arammaki/everflo_remote_control/test/visionaire5-sweep-2026-11-02-ljus/bild_1L_2026-11-02T21-09-09.jpg

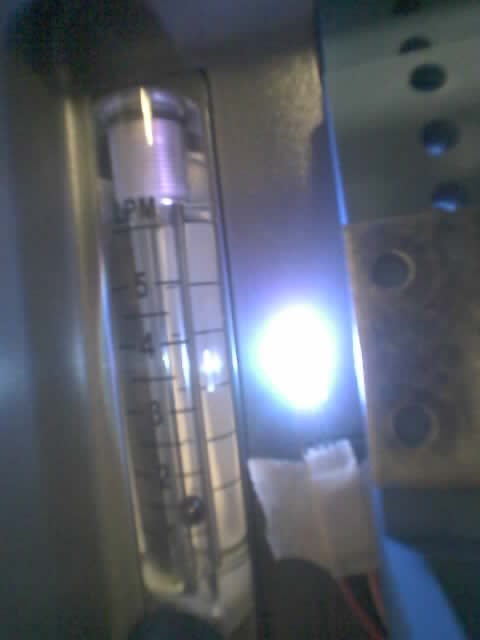
test/visionaire5-sweep-2026-11-02-ljus/bild_1L_2026-11-02T21-09-09.jpg
