arammaki/everflo_remote_control/test/visionaire5-sweep-2026-11-02-ljus/bild_4.5L_2026-11-02T21-11-06.jpg

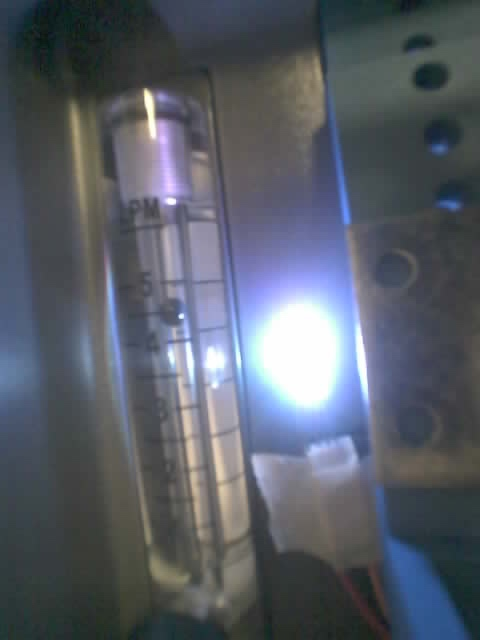
test/visionaire5-sweep-2026-11-02-ljus/bild_4.5L_2026-11-02T21-11-06.jpg
