arammaki/everflo_remote_control/test/visionaire5-sweep-2026-11-02-morker/bild_0_minL_2026-11-02T21-13-30.jpg

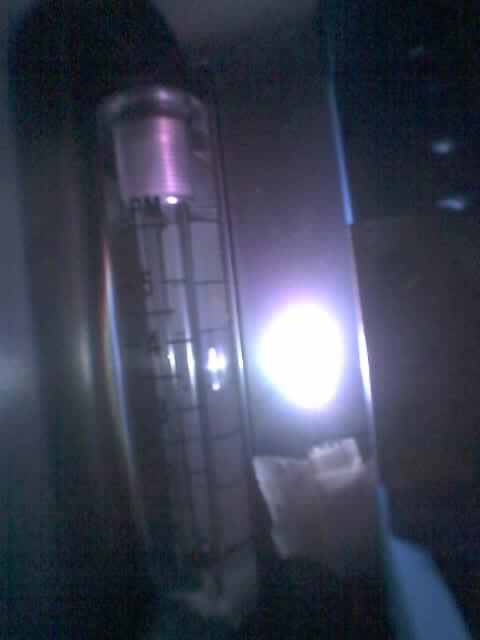
test/visionaire5-sweep-2026-11-02-morker/bild_0_minL_2026-11-02T21-13-30.jpg
