arammaki/everflo_remote_control/test/visionaire5-sweep-2026-11-02-rum/bild_0_minL_2026-11-02T21-58-31.jpg

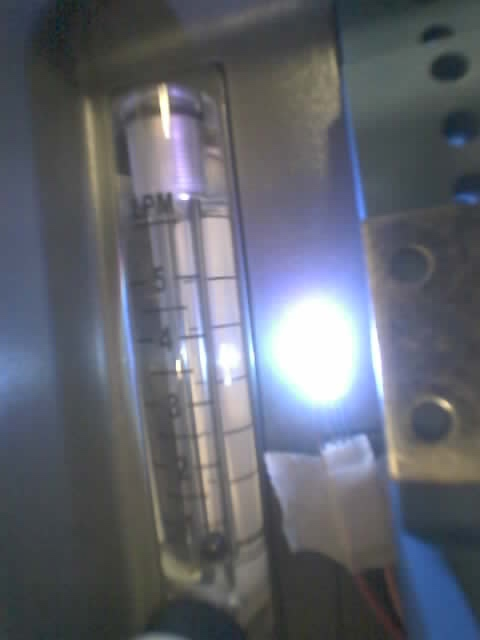
test/visionaire5-sweep-2026-11-02-rum/bild_0_minL_2026-11-02T21-58-31.jpg
