arammaki/everflo_remote_control/test/visionaire5-sweep-2026-11-02b-hall/bild_1.5L_2026-11-02T23-06-17.jpg

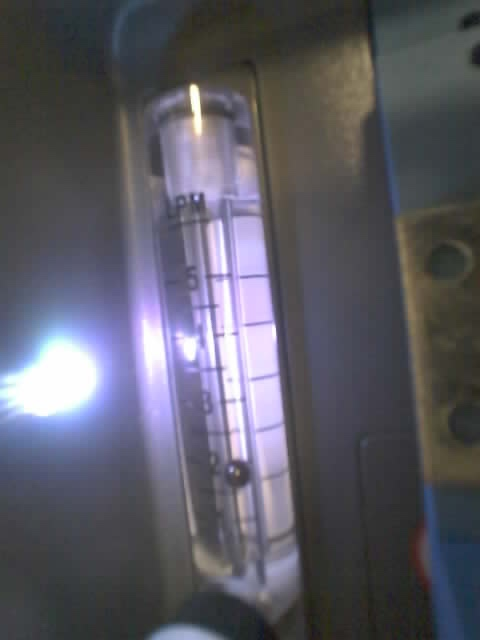
test/visionaire5-sweep-2026-11-02b-hall/bild_1.5L_2026-11-02T23-06-17.jpg
