arammaki/everflo_remote_control/test/visionaire5-sweep-2026-11-02b-hallrum/bild_4.5L_2026-11-02T23-09-16.jpg

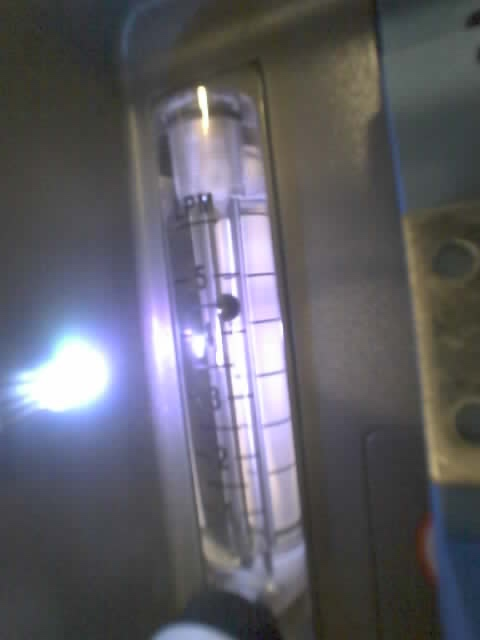
test/visionaire5-sweep-2026-11-02b-hallrum/bild_4.5L_2026-11-02T23-09-16.jpg
