arammaki/everflo_remote_control/test/visionaire5-sweep-2026-11-02b-morker/bild_0_minL_2026-11-02T23-03-06.jpg

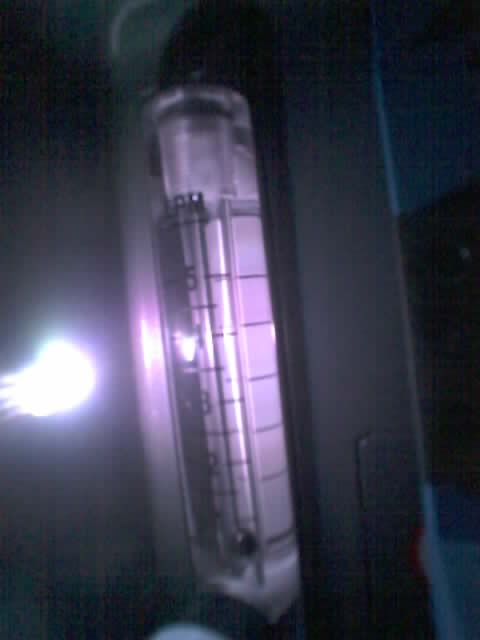
test/visionaire5-sweep-2026-11-02b-morker/bild_0_minL_2026-11-02T23-03-06.jpg
