arammaki/everflo_remote_control/test/visionaire5-sweep-2026-11-02b-morker/bild_4.75_topL_2026-11-02T23-04-46.jpg

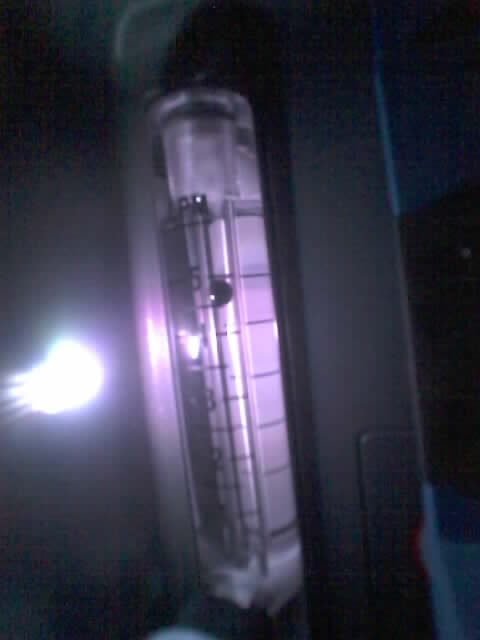
test/visionaire5-sweep-2026-11-02b-morker/bild_4.75_topL_2026-11-02T23-04-46.jpg
