arammaki/everflo_remote_control/(commit log)

2026-08-22 admin: show times in the browser's own zone, not UTC
    The table, the firmware epochs and the selected row's meta line all read
    UTC, which is right for storage and wrong for a person deciding where an
    epoch begins.
    Converting only the display would have been worse than leaving it. The
    epoch filter compares strings, so a table showing local time next to a
    field compared against UTC would take a cutoff copied off the screen and
    be wrong by the offset — two hours here for most of the year, silently,
    and in the direction that quietly excludes everything. So the conversion
    happens once on load and nothing downstream knows about UTC: rows carry
    data-lokal, the firmware options carry local values,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
2026-08-23 v1.10.9: daylight support — the rival evicted, and a second reference
    The first daylit morning after the WS2812 calibration took the reading
    down in two ways on two schedules, and this closes both.
    At dawn, auto-exposure rebalances and the LED's glow at the tube's foot
    goes darker relative to the night reference — a rival blob ramping
    through y 446..465, straight through the resting ball's rows. YBOT
    466 -> 445 evicts the whole ramp and measurably costs nothing: the sweep
    is unchanged to the last digit down to YBOT 440, and the clipped resting
    ball still reads 0.20, so a switched-off machine still says "Under 0,3".
    (Decided with the user: flows in use are 1.5 L/min and up, the bottom
    ne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
2026-08-23 admin: the client script's backslashes never reached the browser
    The epoch filter's client code lives inside renderPage's template
    literal, and a template literal eats unknown escapes: \d becomes d,
    \( becomes (. So the date pattern arrived in the browser as
    /^d{4}-d{2}.../ — matching no real date, which is why picking a firmware
    in the dropdown showed "Datumet går inte att tolka" for a perfectly good
    value — and the label regex arrived as /([^)]*)/, which swallowed
    "v1.10.9 (" up to the first close-paren, leaving a nameless option with
    a doubled parenthesis.
    Every backslash meant for the browser is now doubled in the source. The
    review missed this because it tested the regex extracted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
2026-08-23 admin: one verb for both buttons, and a count on the redo
    "Analysera" and "Räkna om" read as two different operations and they are
    not — one skips rows this engine has already done, the other redoes
    them. Both say "analysera" now, and both carry their count, so the
    epoch's effect is visible before anything runs: "Analysera 12 rader från
    2026-08-23 09:48" next to "Analysera om alla 44 rader".
    Claude-Session: https://claude.ai/code/session_01JSohTikiMUHNrsMTiECuPL
2026-08-23 CLAUDE.md: the afternoon refusals were an artefact, not a ball in flight
    The plausible stories — a bobbing float, a press landing mid-capture —
    were both wrong: the blob's half-width matches sharp frames, so nothing
    moved. Measured instead: a standing afternoon-only artefact at y=309
    (absent at 10:00, 0.065 by 15:30 local) that bites when the ball's own
    peak runs weak. Same family as the historic low-sun artefacts. Watch
    item recorded: afternoon margins run thin; rebuild REF_DAY with
    afternoon frames if sunnier days push it up.
    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
2026-08-23 v1.10.10: the day reference learns the afternoon
    The morning-built REF_DAY met the afternoon and lost margin to it: a
    standing artefact at y=312 in the difference — afternoon light diverging
    from a morning reference — grew from 0.050 at 13:30 to 0.100 by 17:31,
    refusing four frames whose ball peak ran weak. The engine's hidden
    readings were right all along (1338 read 4.83 against the span's known
    4.80); what was lost was availability, not accuracy.
    REF_DAY v2: 25 frames spanning the whole daylit day, 06:52-19:52, ball
    positions spread so every row stays a small minority in the stack.
    Measured against all 118 of the day's uploads and the 23-frame night
    sweep: 117/118 read (v1: 114), no r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
2026-08-26 admin: pages, newest first
    The table showed the latest 200 rows and nothing older could be reached.
    Now ?page=N&limit=M, with "← Nyare" / "Äldre →" above and below the
    table, the row range and total so the reader knows how deep the archive
    goes, and 100/200/500 per page. The limit is clamped: a page is a page
    weight, not a way to pull the whole archive into one tab.
    The freshness banner takes the newest reading from its own query rather
    than from rows[0] — on page 2 the first row is hours old and would have
    called a healthy device dead.
    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
2026-08-26 admin: on a phone the picture stays put while you step through rows
    Pressing Föregående/Nästa scrolled the page to the selected row, and on
    a phone the picture sits above the table, so every step took the picture
    off the screen — which defeats stepping through rows at all.
    Below 720 px the picture, the reading and the two step buttons now stick
    to the top of the screen while the table scrolls underneath. The picture
    is capped at 30vh and put beside the number instead of above it, so the
    block stays short; the block's measured height feeds scroll-margin-top on
    the rows and the header row's sticky offset, so a selected row lands just
    under the picture instead of behind it. Rows are centr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
2026-08-26 admin: stepping through rows never moves the page
    scrollIntoView scrolls every scrollable ancestor it needs to — the page
    included — so on a laptop, where the table has its own scroll box, each
    arrow key or Föregående/Nästa nudged the whole page and pushed the
    picture partly off the screen. Replaced with a reveal() that scrolls only
    the table box on a laptop (row centred in it, page untouched) and, on a
    phone where the table is the page, centres the row in the space below
    the sticky block. Keyboard and buttons share the path.
    Verified: 12 arrow keys plus three button presses at 1280 px leave
    window.scrollY at 0 with the picture fully visible and the row centred
    in the box; at 390 px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
2026-08-26 v1.10.11: evening is a third regime
    Late afternoon and dusk are neither day nor night — low sun through the
    window, and the LED's share of the light rising as it fades. Against the
    day reference the evening frames read high as registration slid toward
    0.8, and the gates began taking frames by fractions: id 1519 missed
    registration by 0.014 with a hidden 4.75 against its neighbour's 4.74,
    id 1521 missed contrast by 0.008 with a hidden 4.05 against 4.03. The
    user confirmed seven of the eight refusals against the pictures before
    this went in.
    It is not only availability. Id 1516 put the ball at y=337 where its span
    neighbours sat at y=342 — a five-pixel position error, not a calibration
    of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
    [everflo_remote_control.ino]
2026-08-26 CLAUDE.md: a span can end without a press — the machine gets switched off
    She turns the concentrator off when she goes out, so the float drops to
    its stop and comes back: 4.65, 0.26, 3.50 across two periodic frames on
    2026-08-26 with no press between them and nothing wrong. In the log that
    is indistinguishable from a knob turned by hand, and both are real — so
    such a span is not one knob position and must not be used as an anchor.
    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
2026-09-05 test: the labelled sweeps, and the harness that was skipping three of them
    The repo held everything derived from the 2026-08-22 sweep — REF_PNG, the
    bands, BASE_TILT, CAL — and nothing to derive it from, so validate_engine.mjs
    had no data to run against and a recalibration had nothing to be compared
    with. The 23 frames go in as test/sweep-2026-08-22.
    The 78 frames of the 2026-08-13/15/16 sweeps go in as test/negative-old-poses.
    Their labels are worthless now, which is what makes them useful: a frame from
    a camera pose that no longer exists must be REFUSED, and these are real
    frames rather than synthetic ones. All 78 are refused, at registration
    0.29-0.58 against the 0.75 gate. The harne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
2026-09-05 test: fail loudly on a label the harness cannot assert anything about
    Review of 730bedb found the silent skip relocated rather than removed. The
    new filter accepted any bild_<something>L_ name, and an unrecognised
    <something> got no expectation, fell through every branch and could not fail:
    one frame renamed bild_2,5L_... with a comma would be listed, never compared,
    and the run still green. A directory where nothing is recognised printed
    "0 with a labelled value ... 0 outside tolerance" and exited 0.
    parseName() now returns what the frame must PRODUCE — 'value', 'reading' or
    'max' — and an unrecognised label stops the run with exit 2 instead. That also
    settles a contradiction the heade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
2026-09-05 test: the negative set constrains registration, not ambiguity
    Second review round. The correction I made in b73001f was wrong in the same
    way the first one was, and for the same reason: I read judge()'s printed
    reason. judge() returns on the FIRST gate that fires and tests margin before
    dx/dy, so a frame failing both prints "två lika starka kandidater" and looks
    like an ambiguity catch. Measured with every gate evaluated independently
    over the 78 wrong-pose frames:
    registration refuses 76, and is the ONLY gate refusing on 8
    ambiguity refuses 49, and is never the only gate refusing
    shift refuses 24, never alone
    spread refuses 24, never alone
    contrast refus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
2026-09-11 CLAUDE.md: what an invalidated lighting looks like in the log
    Nine frames on 2026-09-07, 16:51-17:53 local, refused with night, day and
    evening all collapsing together — the old floor lamp from before the WS2812
    was switched on for an hour. The lamp is gone and this does not recur, but
    the frames stay in the archive, so the explanation belongs next to them
    rather than being re-derived by whoever finds them.
    The shape of it is the useful part: every reference refusing at once, while
    the readings they would each give still agree to 0.01. And brightness does
    not identify it — the refused frames average 128-143 where frames that read
    fine either side average 108-137. Registration caught it,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
2026-09-11 v1.10.12: when the best-registering reference refuses, ask the next
    analyze() sorts the references by registration and takes the best, as before.
    The new branch: if judge() refuses that one, the next best is tried, and the
    first that passes every gate on its own answers instead. The result carries
    fallback:true when that happened.
    Registration is measured on the anchor band — the scale ticks at x 233-261 —
    while the artefact that decides these frames sits at the foot of the tube in
    the ball band, where the LED is. The two are decoupled, so a reference can
    match the ticks best by a thousandth and be wrong about the foot. At dawn on
    2026-08-30 frame 2386 had night 0.901 against day 0.897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
    [everflo_remote_control.ino]
2026-09-11 admin: show which reference answered, and jump straight to a frame
    Two things, both from using the page to check the v1.10.12 readings.
    `ref` and `fallback` were computed by the engine and readable nowhere: the
    quality chips render a fixed six metrics, and cleanQuality() whitelists the
    same six server-side, so neither could reach D1 even if a client sent them.
    The comment in balldetector.js called fallback "the first thing to look at
    when a reading sits a few hundredths off its neighbours" while throwing it
    away. Now it is a chip beside the numbers — marked when it was the second
    reference asked — and it is stored, because that question gets asked months
    later from the table rather than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
2026-09-11 admin: regenerate, and refuse an id that is not digits
    Review of 2ad72cd. build_webui.mjs --check failed at HEAD: the comment
    corrections in the previous commit were never regenerated into the two pages,
    the .h and the Worker's engine.js. That is not cosmetic — ENGINE_VERSION is a
    content hash over the whole file, so deploying as it stood would have
    published a0d18a54 and re-analysed the archive under it, and whoever next ran
    the generator would have minted a third hash for a comment-only difference and
    re-analysed all 4408 rows AGAIN. "Tidigare motor" would then fill with an
    identical value, which is precisely the false comparison that column's own
    comment warns against. Regenerated: a0d1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
2026-09-11 admin: count the rows D1 charges for, and stop scanning for a closed panel
    The Worker hit D1's free tier daily row-read limit and threw 1101 on every
    request, on the first statement of the handler — before any of the day's
    changes ran, so the deploy was innocent and a rollback would not have helped.
    What consumed the quota is not known, and that is the finding. Adding up the
    day's harvesting comes to roughly fifty thousand rows, not five million, and
    nothing recorded the number that would have settled it: D1 returns
    meta.rows_read on every statement and this Worker discarded it. Every
    statement now goes through meter(), which sums rows_read and rows_written for
    the request and logs one li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
2026-09-12 Arm while you can still drive over, not once you have seen it boot
    The rule said: only ever arm a build that has already been seen to boot over
    cable or ArduinoOTA. Read literally that makes the cloud path pointless —
    standing next to the unit you do not need it, and away from it you can never
    satisfy the condition. The operator's actual rule, and the one that holds:
    do not arm unless you are close enough to drive over and fix it.
    What the old wording was reaching for is the rollback direction, where it is
    exactly right. There is no bootloader rollback, so the only way out of a bad
    build from a distance is to arm a DIFFERENT one, and that one has to be a
    build known to boot — which is w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
2026-09-26 v1.10.13: concentrator presets — EverFlo kept intact, Platinum 9 empty until calibrated
    Mum moves to an Invacare Platinum 9 (1-9 L/min). Everything tuned for one
    machine becomes a preset: in balldetector.js the bands, window, tilt, curve,
    Max/bottom states and texts, display crop and lighting references; in the
    sketch the button step sizes and direction. CONCENTRATOR in the sketch picks
    one at build time — never on the page or over the API.
    The analysis functions are untouched: usePreset() assigns the same names the
    constants had. On 413 frames (sweep, 78 negatives, 312 uploads across all
    three references and two fallbacks) every field of analyze() and judge() is
    bit-identical to v1.10.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
2026-09-26 tools: calibrate.mjs builds a preset's reference and curve from a sweep
    Per-pixel median of the gray frames as an 8-bit PNG (zlib, no npm), then a
    least-squares quadratic over the engine's own y. Self-test on the 2026-08-22
    EverFlo sweep: the reference is bit-identical to the committed REF_PNG and
    the curve is within 0.0005 L/min of the committed CAL. Geometry is only
    suggested, and says it is approximate (ball band 13 px narrow on the left,
    lean 0.075 against the chosen 0.066).
    Claude-Session: https://claude.ai/code/session_0149wzTMng27AnG2Mh3Xvdgd
2026-09-26 v1.10.13: presets — review fixes
    From the cold review of the two preset commits:
    - Her page parses on Safari < 13.4 again (no ??), and keeps the picture and
    the buttons when /motor.js fails to load, with an honest message.
    - A calibrated preset must be complete: usePreset() refuses a curve with any
    state left null (null compares as 0) or no references.
    - LED_LEVEL is per machine: the references are bound to it.
    - /api/status carries her three button sizes; the panel uses them instead of
    EverFlo's 39/90/160. The #if guard now orders all three steps.
    - Control panel: every early return clears the number (the shell invariant),
    the preset is asked again after lost contact (a reflash o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
    [everflo_remote_control.ino]
2026-09-26 v1.10.13: presets — second review round
    - Admin: analyse the row's own canvas, never the shared visible one, which a
    concurrent select() can repaint while this one awaits loadRef() (a
    regression from the first round's draw-first change).
    - presetOf() lives once, in tools/preset_of.mjs, imported by the admin Worker
    (bundles fine), publish_firmware.mjs and score_uploads.mjs.
    - score_uploads refuses a meta.json without fw/preset columns: fetched with
    the older command it cannot tell an EverFlo row from an unrecorded one.
    - Control panel: button sizes are filled once per host and machine, so a
    lost contact no longer overwrites a step the operator typed; an exception
    in analyze() cl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
    [everflo_remote_control.ino]
2026-09-26 v1.10.13: presets — third review round
    - Admin: a slower earlier selection no longer paints its frame or reading
    over the row now selected; its reading is still stored for its own row.
    - Device page: the reason for "no reading" is shown at once, and put back
    only when the line is empty, so press() and restart() feedback survives.
    - Control panel: button sizes follow the device unless the operator typed in
    the fields (an input listener, not a host|machine key); an analysis
    exception is reported in Swedish, details to the console.
    - ota_flash.sh refuses an image that names no preset instead of silently
    skipping the machine check, and the version test is anchored like
    presetOf()'s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
    [everflo_remote_control.ino]
2026-09-26 v1.11.0: build for the Invacare Platinum 9
    CONCENTRATOR -> CONC_PLATINUM9. Minor, not patch: the machine still needs
    its calibration sweep, and until then the page shows the picture and the
    buttons and no number. Step sizes, direction and LED level are still the
    EverFlo values — measure them on site before the sweep.
    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
2026-09-26 Presets: pre-push review fixes
    - Control panel: step sizes reset to the device's on a new host or machine,
    and keep a hand-typed value only within the same one; an analysis error
    shows its detail, since the phone the panel runs on has no console.
    - Admin: a row passed by on the way to another is dropped after its image
    loads, before any analysis, so a held arrow key no longer queues a
    flatfield per row; the canvas is cleared when the selected row has no
    frame of its own to show.
    - Device page: one helper says why there is no number, on the empty line only.
    - ota_flash.sh checks the image names a preset right after the version check,
    before any network probing, and drops the fallb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
    [everflo_remote_control.ino]
2026-09-26 Presets: second pre-push review round
    - Admin: the canvas is cleared only when the selected row's own frame never
    arrived; a failure after the draw keeps that row's picture.
    - Control panel: step fields are protected one by one, and only against an
    actual change of host or machine — a value typed before the first answer
    stays. Firmware before 1.10.13 gets EverFlo's 39/90/160 (history); an
    unknown machine empties the fields so every press refuses until one is
    typed. The analysis-error detail is labelled technical and never
    "undefined".
    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
2026-09-26 Presets: step fields follow one rule; admin blanks unless its frame was drawn
    The step-field logic had grown case by case and each review found another
    gap. It is now one function with one rule: a change of device or machine
    drops hand-typed values and fills what can be vouched for (the device's
    sizes, EverFlo's 39/90/160 from firmware before presets, or nothing, which
    makes presses refuse); the same device and machine keeps hand-typed fields,
    also across a lost contact; the first answer is not a change. Unknown
    machines go through the same rule instead of their own branch.
    Admin: the canvas is cleared whenever the selected row's own frame did not
    make it onto it, whatever the error; load()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
2026-09-26 v1.11.1: /api/fw-check asks for an armed build now
    Moves the firmware question forward instead of waiting up to 15 minutes.
    It cannot start an update by itself — only a build a person armed is ever
    installed — and it is not honoured within 30 s of the last ask, since each
    check blocks loop() for a TLS request. The boot-loop guard (lastFwCheck
    seeded at boot) is untouched.
    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
2026-09-26 v1.11.2: Platinum 9 calibrated; her page crops to the meter; buttons 40/60/120
    The platinum9 preset is filled from a 21-frame sweep (2026-09-26, night,
    WS2812 + ceiling lamp): ball band x 312..324 on the ball's dark body (the
    highlight beside it cancels a band centred on it), anchor 264..292, window
    138..405 between the top coupling and the bottom fitting, tilt 0.03, curve
    fitted to mean 0.099 / worst 0.296 L/min. All 21 frames clear every gate;
    margins contrast 0.146, ambiguity 4.8x, registration 0.952. Max is above the
    red line. One reference, 'kväll' — lamp-off nights and daylight still to come.
    Cross-machine: Platinum frames read as EverFlo are refused 21/21, EverFlo
    frames read as P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
2026-09-26 v1.11.2: Platinum review fixes — bottom boundary, scale check, comments
    - LOW_FLOW 0.3 -> 0.2: the 0.5 L/min frame reads 0.26 and was shown as
    "Under 0,3"; the resting ball (-0.74) still gives the bottom state.
    - The curve was checked against the printed scale: the ticks agree with it
    within ~0.05 from 1 to 6 L/min (the 1.5 and 2.5 residuals are the labels),
    and it reads up to 0.4 high above ~7. Recorded in the CAL comment and
    CLAUDE.md, with the tick-fitted alternative.
    - Comments: LED_LEVEL is what the sweep was taken at; the step sizes; the
    device page CSS no longer cites a fixed 225x640 canvas.
    - CLAUDE.md lists the open risks: EverFlo-sized pixel constants on a tube
    with h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
    [everflo_remote_control.ino]
2026-09-26 v1.11.2: fit the Platinum curve to its printed scale; side-read labels are approximate
    Above ~5 L/min the motor mount blocks the front view, so those sweep labels
    were read from the side, and the label-fitted curve read up to 0.4 high at
    the top (parallax). The ticks, found in the reference's anchor band, give
    the scale directly: the engine's y reads 6.5 px below the tick (measured on
    the straight-on frames 1..5), and a quadratic through ticks 1..9 lies within
    0.09 of each. Against the straight-on labels: mean 0.08, worst 0.26 (2.5,
    where the scale also puts the knob above the mark).
    Frames read at an angle, and those below the calibrated range, are named
    <n>_approx — a new label form in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
2026-09-26 v1.11.2: Platinum — offset without the judged labels, Under 1, Max at the red line
    From review of the scale fit:
    - The tick offset is fitted on the straight-on frames WITHOUT 1.5 and 2.5
    (6.75 px), so it no longer leans on the two labels it is used to judge;
    the rest agree with the scale within 0.03, and 1.5/2.5 still sit +0.20/
    +0.27 off. Y_CAL_MIN/MAX are the ticks 9 and 1.
    - Below 1 L/min the tick-fitted curve reads low on the stretched scale, so
    there is no honest number there: "Under 1" (the machine's own alarm
    point), with the boundary at 0.8 on the curve so a clean 1.0 does not flip.
    - Max starts at the red line (engine y 165); the "on the red line" frame was
    judged from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
2026-09-26 v1.11.2: Platinum review — Max text without a number, docs match the approx bound
    Max now starts at the red line (~9.6 on the curve), so its text no longer
    names 9 L/min. The approx-frame bound is described the same way in the
    harness, calibrate.mjs, CLAUDE.md and test/README.md. The tick-fit error is
    stated as within 0.1 (worst tick 7, -0.092).
    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
2026-09-27 v1.11.3: knob calibration and flow-step buttons; band fields per machine
    Control panel — "Kalibrera ratten" measures how many degrees the knob needs
    per L/min along the scale. It turns under 1 and back up to 1 (approaching
    from below, backlash taken up), climbs in small steps to just under the
    preset's top (never above 9; the step before Max is not taken), reading the
    median of three frames requested after each settle, measures the backlash on
    reversing where the scale can be read (a fall confirmed by a second), and
    returns to the starting flow closed on the reading. It aborts rather than
    turns on: Max, the flow going the wrong way or not moving once it has (the
    checks restart at every rev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
    [everflo_remote_control.ino]
2026-09-29 v1.12.0: access control; step from the settled ball; faster knob calibration
    Access control, for a shared or public wifi. With CONTROL_AUTH 1 (default;
    0 is the old behaviour) plus/minus, step size, light, colour test, restart,
    firmware check and counter reset need CONTROL_KEY from secrets.h; picture,
    reading, status and log stay open. A build with 1 and no key does not
    compile, and the example key is empty so a copied example cannot build with
    a public one. Minor version: her phone must be paired, or her buttons stay
    hidden.
    Challenge-response, since a key sent along on an open network would be
    captured and replayed: the client fetches a nonce and sends
    HMAC-SHA256(key, "<path>?<query up t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
    [everflo_remote_control.ino]
2026-09-29 v1.12.1: recalibrate the Platinum 9 for the moved camera, in daylight
    The camera was moved and the 2026-09-26 calibration refused every frame of
    the new sweep (registration 0.31-0.46). New sweep 2026-09-29 14:39-14:45 in
    daylight: new bands, tilt 0.065, window 160..392, tick-fitted curve and a
    'dag' reference. The old sweep becomes a negative set, refused 21/21.
    calibrate.mjs had not been told about KNOB/BACKLASH and refused to run.
    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
    [everflo_remote_control.ino]
2026-09-29 Control panel: continue an aborted knob calibration; steady status line
    The climb is saved per machine after every step, and "Fortsätt förra"
    approaches a point 0.3 L/min under where it ended from below, anchors that
    reading in the saved table and climbs on. A printout pasted into the result
    box works the same way, for a run this browser did not save. The status line
    reserves two lines and spans both columns, so a reason that comes and goes
    no longer makes the page jump.
    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
2026-09-29 v1.12.2: a late-afternoon reference for the Platinum 9
    Against the 16:40 daylight reference alone the later light refused readings
    around 4 L/min and stopped the knob calibration. A second sweep at 17:47
    local in that light gives REF_PNG_PLATINUM9_KVALL, each frame shifted back by
    its own dx/dy so the reference shares the first one's coordinates and every
    band and the curve apply unchanged (tools/align_reference.mjs). 4 of its 20
    frames are still refused under the free tilt search; locked at tilt 0 all 41
    frames of both sweeps read. The negative and cross-machine suites still
    refuse everything. Sweep times in the docs corrected to local: the file
    names carry UTC.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
    [everflo_remote_control.ino]
2026-09-29 v1.12.3: the Platinum 9's knob table; abort a calibration in a hidden tab
    KNOB and BACKLASH (35 degrees) from the first real "Kalibrera ratten" run,
    three runs joined with "Fortsätt förra", tilt locked at 0. With them her page
    shows the flow-step buttons. Taken as printed: smoothing away the reading's
    stickiness at each whole mark moves no row by more than 10 degrees.
    The control panel now aborts a run when its tab is hidden, saying why: a
    hidden Safari tab has its timers slowed, and the run used to end in "no still
    reading" for a reason that had nothing to do with the meter.
    Claude-Session: https://claude.ai/code/session_0149wzTMng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
    [everflo_remote_control.ino]
2026-09-29 v1.12.4: no fallback to a clearly worse reference; safer flow buttons
    At dusk the resting Platinum ball read 1.42-1.65 L/min: 'kväll' refused it,
    and 'dag', registering 0.08-0.09 worse, answered through the fallback with
    every gate green. The fallback now only asks references within 0.05 of the
    best registration — the EverFlo rescues it exists for were 0.008-0.037
    apart. The dusk frames now refuse.
    Her flow buttons, from review: they lock before the status request, so a
    double tap cannot turn twice; the slack is left out of any turn that would
    cross 1 or the top if it were already taken by hand; a turn under 4 degrees
    to the limit itself says "already at the limit". BACKLASH 35 -> 21: th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
    [everflo_remote_control.ino]
2026-09-29 v1.12.5: a pairing link must be accepted by the device; refusals say why
    From the review of 1.12.0's access control (no way past the lock found):
    - A #k= link no longer replaces a stored key on trust. The page makes a
    signed read of /api/steg with the new key and keeps it only if the device
    accepts it, so a link from anyone cannot silently unpair her.
    - Only a 'key' refusal asks for a new pairing link; a second lost nonce race
    says "tryck igen". Same on the control panel.
    - The fixed-degree buttons get the 6 s timeout they never had (a unit going
    dark mid-request kept every button disabled), and the flow buttons' budget
    goes from 4 to 6 s now that it covers the nonce and its retry.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
    [everflo_remote_control.ino]
2026-09-30 v1.12.6: recalibrate the Platinum 9 at the care home
    The unit moved to the care home and the camera with it: the kitchen
    calibration refused all 20 frames of the new sweep. New geometry (band
    298..308 at tilt 0, anchor on the digits, window 140..395), a reference
    built from frames aligned to the median (the camera moved dx -4 -> +8 during
    the sweep), and a curve fitted to the printed ticks with a ball-to-tick
    offset that grows with height (11 px at 1, 20 at 7): the camera sits lower
    relative to the tube. 20/20 read; straight-on labels mean 0.08, worst 0.24.
    Both kitchen sweeps of 2026-09-29 become a negative set, refused 41/41. The
    knob table and backlash are the machine's and carry over.
    C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
    [everflo_remote_control.ino]
2026-09-30 v1.12.7: a night reference for the Platinum 9 at the care home
    REF_PNG_PLATINUM9_NATT from a 20-frame sweep with the lamp off and the
    curtains drawn, aligned to itself and then into the day reference's
    coordinates. Never fitted to, the night sweep reads 18/20 at mean 0.087 —
    an independent check of the curve. Its resting ball and 0.5 refuse under the
    free tilt search; at tilt 0 all 40 frames of both sweeps read. Negative and
    cross-machine suites still refuse everything.
    The two sweeps also show the camera moving with the knob, repeatably: dx
    -4 -> +8 from 0 to max in both, and back between them.
    Claude-Session: https://claude.ai/cod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
2026-09-30 v1.12.8: review of the care-home calibration — 1 L/min reads 1.0; honest notes
    From a cold review of 1.12.6 (no engine defects):
    - The curve weights the 1 mark 5x in the tick fit: unweighted a clean
    1 L/min read 0.94, shown "0,9" (under the machine's own alarm mark) and
    outside the flow buttons' range. Now 0.97; ticks still within 0.08,
    labels mean 0.087.
    - The Max boundary is an extrapolation, and the notes now say so: the one
    frame judged "on the red line" reads 9.41, 10 px under it. An over_max
    frame at the next visit settles it.
    - Why the reference is aligned is a trade-off (more contrast, less
    ambiguity margin), not a rescue; the tilt and anchor numbers were wrong.
    - tools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
    [everflo_remote_control.ino]
2026-09-30 v1.12.9: drop the +0,2 flow buttons; the save label steps by a set amount
    Her page keeps +1/+2 and -1/-2: a 0.2 L/min step sits inside the reading's
    own error and the knob's slack, and was unreliable on the unit.
    The control panel's "Spara bild" now adds a settable step (default 0.5,
    0 turns it off) to a numeric label after each save, so a sweep walks the
    scale without retyping. States such as 'max' or '9_approx' stay as they are.
    Claude-Session: https://claude.ai/code/session_01B11t8JyqFyTUYMFi2PaWKs
    [everflo_remote_control.ino]
2026-09-30 v1.12.10: recalibrate the Platinum 9 for the care home's afternoon pose
    The camera was moved again; the morning calibration refused the new sweeps.
    New geometry (band 306..318 at tilt 0.07, anchor on the ticks 272..292,
    window 170..420), day and night references built aligned, the curve fitted
    to the ticks with a height-growing offset and the 1 mark weighted. Day 21/21
    and night 20/20 read under the free tilt search, mean 0.094 each; the whole
    marks within 0.12 (day) and 0.18 (night).
    The morning sweeps become a negative set, refused 40/40. The 2026-09-29
    kitchen sweeps are no longer one: 8 of 41 read against this pose, within
    0.13 of their labels — the camera ended up close to its kitche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
    [everflo_remote_control.ino]
2026-09-30 v1.12.11: switch off the flow-step buttons on the Platinum 9
    Her page goes back to the fixed-degree buttons + ++ +++ only: the operator
    judged the flow steps too uncertain — the camera moves with the knob, and
    every pose change costs a recalibration they lean on. KNOB and BACKLASH are
    null in the preset, which is the designed switch; the measured table stays
    in a comment, and the code behind the flow buttons stays in place.
    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
    [everflo_remote_control.ino]
2026-09-30 v1.12.12: the Platinum 9's smallest button turns 30 degrees, not 40
    The operator's call on the unit: + and - now turn 30 degrees, ++ and +++
    stay at 60 and 120. Roughly 0.3 L/min per + between 1 and 4, 0.15 between
    4 and 5, where the knob is stiffer.
    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
    [everflo_remote_control.ino]
2026-09-30 v1.12.13: pair her phone from inside the page, for a home-screen web app
    A web app saved to the iPhone home screen has its own storage and no address
    bar, so a pairing link opened in Safari never reached it. While the phone is
    unpaired, or after the device refused its key, her page now shows a field to
    paste the link (or the bare key) into; the device checks it exactly as it
    checks a link, so a wrong one pairs nothing. The page also declares itself a
    web app, named "Syrgas" on the home screen.
    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
    [everflo_remote_control.ino]
2026-09-30 v1.12.14: keep the calibrated tilt unless another registers clearly better
    A steady 3.8 L/min on the unit flickered to "Osäker": the tilt search
    stepped 2 degrees off for a registration gain of 0.001-0.022, the sheared
    band ran onto the ticks near the top, and ambiguity fell under the gate —
    the third time in two days. The READING now stays at BASE_TILT unless
    another tilt registers TILT_MARGIN (0.03) better; `reg` stays the best over
    all tilts, since it also ranks the references and gates the fallback (the
    first version used the base tilt's lower value there, and a review found a
    turned night frame read 1.64 for a true 2 through the day reference).
    Measured over every set: the live fram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
2026-10-01 Admin: draw the candidates the engine weighed over the frame
    For a refusal like "två lika starka kandidater" the page now shows what the
    engine saw: the ball band it read (shifted by dx, sheared by its tilt), the
    difference profile as bars beside it, the search window, the strongest
    candidate in green and the strongest rival outside the 60 rows around it in
    red with the ratio. Display only; a checkbox turns it off. On the first
    evening refusals at the care home it shows the profile raised along the whole
    tube — the LED's reflection down the band in a light neither reference has —
    rather than a second ball.
    Claude-Session: https://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
2026-10-01 Admin: show the frame's id and time above the reading
    "Bild 6767 · 2026-10-01 09:43:34" sits on top of the reading for the selected
    row, so the frame on screen can be named without finding its row; the time
    leaves the meta line below, which keeps the rest.
    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
2026-10-01 v1.13.0: read the Platinum through the camera's new pose
    The camera settled 22-27 px to the side on 2026-09-30 18:17 and every frame
    after it was refused (131 of 142) while the ball sat where the engine had
    found it. Two causes:
    - The sideways gate (20 px) was refusing frames that read right. SHIFT_X is
    30; dy stays 20. The 2026-09-29 kitchen frames, up to 27.8 px to the side,
    read the whole marks within 0.14 once allowed; they move from the negative
    set to platinum9-kitchen-2026-09-29, which is now in the suite and must
    read. Not more than 30: the EverFlo's 34 px slide of 2026-08-16 read 1.73
    for 2.0 with every other gate green, and no test set holds it.
    - The references no longe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
2026-10-05 v1.14.0: build for the EverFlo again
    The unit is back on the EverFlo, for now. Its preset still carries the
    kitchen calibration of 2026-08-22, which refuses every frame of the new
    pose (registration 0.13-0.54 on today's uploads), so until the new sweep
    is in, her page shows the picture and the EverFlo's own button sizes
    (39/90/160) with no number. Minor: a recalibration is part of the job.
    Claude-Session: https://claude.ai/code/session_01Ld39EKvxTZkHvtPnrMEjMA
2026-10-05 v1.14.1: calibrate the EverFlo in its new pose, three lightings
    The EverFlo is back on the unit with the camera much closer to the tube than
    in the kitchen. Three sweeps of 2026-10-05 in one pose: the hall lamp on
    (test/everflo-sweep-2026-10-05-hall), dark (-natt) and the room lamp on
    (-rum), 13 frames each, 0.5..5 in halves, rest, the top line and past it.
    References 'hall', 'natt' and 'rum', plain medians in shared coordinates
    (each median's own curve is within 0.05 L/min of CAL). Band 285..304, anchor
    245..265, tilt 0.035 from a grid over the hall sweep (ambiguity 4.4-4.8x,
    registration 0.98 on the whole plateau). The curve is fitted to the hall
    labels, mean 0.012, worst 0.029; the dark a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
2026-10-18 v1.14.2: two EverFlo references for the camera's 2026-10-18 pose
    The camera moved twice on 2026-10-18: crooked from 13:10 to 16:10 local
    (every frame refused, correctly), then back about 11 px to the other side of
    the 10-05 pose, where frames read but with rivals near the top line. Two
    sweeps in the new pose, lights on and dark, give references 'ljus' and
    'natt2', aligned into the 10-05 coordinates: 'natt2' twice against the old
    'natt' and left there, 'ljus' twice against 'hall' and shifted onto its
    printed scale. CAL and the bands stay; the 10-05 curve reads both sweeps
    within 0.062. Ambiguity on the new sweeps goes from 2.6-11x to 5.4-112x; the
    uploads since 16:19 read 9 of 10, the crooked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
2026-10-18 v1.14.3: an uncertain reading shows both candidates on her page
    When the engine refuses because two candidates are about equally strong, her
    page now says "Osäker" and shows both: the stronger one large, "eller" the
    other under it, in amber. judge() returns them for the ambiguity gate only,
    each through the same Max and bottom states; registration, shift and
    contrast refusals still show no value. It remains a refusal: nothing steps
    from it. Frame 9396 (the ball at the top line) now shows "Osäker / Max /
    eller 2.0". Every suite reads as before.
    Claude-Session: https://claude.ai/code/session_01AxdjCdeTXgYrBToyTswo6V
2026-10-18 Test: the second 10-18 light sweep and two dark bottom frames
    Taken after 1.14.3 landed, with labels that match the pictures. The light
    sweep reads within 0.054 at ambiguity 9.7-29x and its resting ball says
    "Under 0,3"; the two dark frames (rest and 0.5) join the 10-18 dark sweep.
    Neither is used for a reference: they test the 1.14.2 ones and close the
    bottom-of-scale gap in this pose. Engine and firmware unchanged.
    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
2026-10-19 v1.14.4: her page says so when a press moved nothing
    The firmware has no motor feedback. On 2026-10-19 a knock unseated the
    unit and every press was logged as a turn while the cup stood still.
    The page now compares the frame before a press with one 2.5 s after the
    motor stopped (largest 16x16 block change, brightness matched) and
    warns under 8. Measured on 43 presses: still 3.1-5.4, moved 13.4-154.
    Pixels rather than the reading, since the same knock moves the camera.
    Claude-Session: https://claude.ai/code/session_01PT3MAaYhv9Zba4ZYMejnnF
2026-10-19 v1.14.5: EverFlo references for the camera's 2026-10-19 pose
    A knock tipped the camera; screwed down again it sits near the 10-05 pose,
    and the old references read the new sweeps right but with rivals (light
    1.6-7.2x, four frames refused; dark 1.5-5.8x). Two sweeps, references
    'ljus3' (aligned against 'ljus') and 'natt3' (aligned against 'natt2', then
    shifted -1.7 px onto ljus3 by the ticks in the ball band: natt2 sits 1.5 px
    off 'natt' there, and the unshifted natt3 read +0.04 high). Ambiguity on
    the new sweeps 5.5-88x and 4.4-182x, means 0.024 and 0.036; every other
    sweep, the negatives and the 10-18/19 uploads unchanged.
    The sketch is now 3.18 of 3.34 MB: no further reference fits withou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
2026-10-19 v1.14.5: correct the old references' margins in the notes
    Review: the dark sweep under the old references was 1.5-10.8x, not
    1.5-5.8x; the light sweep refused five frames, not four; the light
    frames' dy against ljus3 is 5.9-10.4. Comments only.
    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
2026-10-21 v1.14.6: an evening and night reference for the 2026-10-19 pose
    In the evening and at night frames went to 'natt2'/'natt' with a rival
    near the top: 46 of the 440 uploads since 1.14.5 said "Osäker", the
    larger candidate always the ball. Those references won on a registration
    over 1 (1.06-1.10 against natt3's ~1.0): align() normalises by the
    unshifted window's energy while correlating the shifted one.
    'kväll3' is built from the uploads those references won (even ids, odd
    held out: 21/21 read at 4.0-8.6x), aligned to natt3 and shifted onto
    ljus3 by the ticks. All 440 uploads: 46 "Osäker" -> 0, none refused,
    readings 0.03-0.06 lower than natt2's. 'ljus' (the 10-18 pose) is dropped
    for flash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
2026-10-21 v1.14.6: review fixes to the notes on kväll3 and align()
    The 10-18 light sweeps read through ljus3 alone; verdicts, not outputs,
    are unchanged on the other sets; the 24 -> 20 experiment was on the
    evening frames. Record that the align() normalisation bug also loosens
    the registration gate (a wrong-pose frame refused only by dy, by half a
    pixel), and that rebuilding ljus3 needs 'ljus' from git history.
    Comments only.
    Claude-Session: https://claude.ai/code/session_01ATjRNdTE8Z9WUm1ZcQScmq
2026-10-21 v1.14.7: align() normalises by the window it correlated
    The match quality divided by the energy of the unshifted window while
    correlating the shifted one, so a frame sitting several px off scored
    above 1 by an amount that differed per reference. It made the wrong
    reference win the EverFlo evenings (the cause behind 1.14.6) and it
    loosened the 0.75 registration gate: a wrong-pose kitchen frame scored
    0.77 and was refused only by dy, by half a pixel; fixed, that set peaks
    at 0.68.
    With kväll3 in place: the 440 uploads since 1.14.5 stay at 0 "Osäker"
    and 0 refused, five readings move by at most 0.04, registration
    0.90-0.99. Every sweep and negative set passes; the Platinum kitchen
    set's 14:4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
2026-10-21 v1.14.7: allow the one refused kitchen frame by file name
    Review: ALLOW_REFUSED matched on the label, so '4.5' also exempted the
    15:49 frame at 4.5, which is part of the SHIFT_X evidence and must keep
    reading. validate_engine.mjs now also takes a file name, which allows
    that one frame only. Notes brought up to date with the fix (numbers
    from the review's per-frame comparison).
    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
2026-10-22 v1.14.8: the device's engine carries only its own machine's references
    A build drives one machine, but /motor.js carried both machines'
    reference images, which are the bulk of the engine: the Platinum's five
    were 783 kB of an EverFlo build at 96% of the OTA slot. build_webui.mjs
    now emits one variant per machine into balldetector_js.h, the other
    machine's REF_PNG_* constants set to null, and the sketch includes it
    after CONCENTRATOR, which picks the variant. The pages and the admin
    Worker keep every reference; ENGINE_VERSION stays the full source's hash.
    EverFlo build 3.21 -> 2.41 MB (72%), Platinum build 2.19 MB (65%). Each
    variant's output is identical to the full engine on the 440 upload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
2026-10-22 v1.14.8: review fixes to the per-machine engine build
    build_webui.mjs stops the build when a preset's refs() names constants
    of more than one machine (they would be null on the device), and the
    header refuses to compile without the CONC_* ids (both sides of the
    #elif would otherwise compare 0 == 0). Sizes in one unit; a stale
    "~90 kB of engine" comment.
    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
2026-10-22 Reader Worker: read new uploads on the server, hourly
    A separate Worker (cloud/reader) reads every new frame once an hour and
    stores the reading in analyses under the current engine hash, marked
    src:server, so the admin page no longer has to be opened to get them.
    It runs over the free plan's 10 ms CPU limit per invocation, knowingly:
    reader_state records its place and the frame it is on, gives up on a
    frame after three unfinished runs, and the admin page warns when it has
    stopped or fallen behind.
    build_webui.mjs generates its engine (no reference PNGs) and the
    reference profiles analyze() uses, via tools/reader_profiles.mjs.
    tools/verdict.mjs is now the one copy of how an analysis becomes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
2026-11-02 v1.14.9: sideways gate 30 -> 38 px after the camera jumped to 35.6
    On 2026-11-02 frame 12000 (one -39 press) moved the EverFlo's camera from
    28.9 to 35.6 px sideways with every other gate green; the dx gate alone
    refused it. At 38 it reads 3.69 after 3.85. Every checked-in set gives
    identical output at 30 and 38; of 676 uploads at 24 px or more, 7 change
    (12000 reads, six go back from 'rum' to 'natt3' within 0.03 L/min).
    The operator's call over a recalibration; the mount needs fixing.
    Claude-Session: https://claude.ai/code/session_01GRu7Us52gNutoUT2oNLPVJ
2026-11-02 v1.15.0: AirSep VisionAire 5 preset, calibrated; + stops at Max
    The unit went onto a VisionAire 5 on 2026-11-02. New preset visionaire5
    and build block CONC_VISIONAIRE5 (now the built machine), calibrated on a
    lit and a dark sweep of that evening (test/visionaire5-sweep-2026-11-02-*):
    references 'ljus' and 'natt', aligned medians because the camera moves with
    the knob; geometry from a grid over both sweeps; curve fitted to the light
    labels (mean 0.024, worst 0.069), dark sweep within 0.18 (mean 0.066).
    Every other machine's and pose's frames are refused as a VisionAire, and
    the reverse. Every older set reads identically.
    The knob's top is the Max state, shown as "4,75 (max)": the Max label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
2026-11-02 v1.15.1: VisionAire reference 'rum' for a second lamp
    With a second lamp lit the VisionAire's tube gets a bright streak beside
    the ball's path at 3-4 L/min, and the unit flipped between a number and
    "Osäker" (live at 2.5: 8 of 9 frames refused at 1.4x). New sweep
    test/visionaire5-sweep-2026-11-02-rum and reference 'rum', aligned and then
    shifted (+16.4, -4.4) into 'ljus''s coordinates: the camera had moved
    16 px sideways and 4-5 px up between the sweeps, measured on the scale's
    ticks and the tube's edges, not by registration across lightings. The
    sweep reads at mean 0.034, worst 0.15, nothing refused; the live frames
    read 2.52-2.54 at 23-27x; every other set reads as before.
    Co-Authored-By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
2026-11-02 v1.15.2: her buttons stay put when the reading becomes a state
    The reading on her page now sits in a centred box of fixed height. The
    VisionAire's "4,75 (max)" with "L/min — högsta läget" under it is two
    lines where a number is one, and the buttons below jumped a line when Max
    appeared. The Max/bottom label is a little smaller (3rem) so "4,75 (max)"
    fits one line on a narrow phone.
    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
2026-11-02 v1.16.0: VisionAire recalibrated for the moved LED, level 40
    The operator moved the LED to the left of the tube (at night 1-2.5 L/min
    was too dark to read, and its glare beside the ball made rivals), set it
    to 40, and the camera moved ~33 px with it. New sweeps
    test/visionaire5-sweep-2026-11-02b-{hall,morker,hallrum}; the whole
    preset redone: geometry from a grid over the three (band 220..236, lean
    0.12, anchor on the ticks right of the ball), aligned medians 'hall',
    'natt', 'rum' ('rum' shifted onto 'hall', its camera slid mid-sweep),
    curve fitted to -hall. Nothing refused in any of the three; means 0.033 /
    0.043 / 0.024, contrast at least 0.37, ambiguity at least 11x. Max at
    y 300, crop x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
2026-11-04 v1.17.0: back to the EverFlo; signed /api/forget-wifi
    The unit is back on the EverFlo (CONCENTRATOR, LED 50, its own steps), at
    a new place. There it joined an open WiFi4EU that lets uploads through but
    isolates clients, and kept rejoining it, so the portal never opened and
    nobody could reach the page. New signed /api/forget-wifi (and "Glöm wifi"
    on the control panel): forget the saved network and restart into
    "Syrgas-setup". For someone on site only; the panel's confirm says so.
    It cannot help on an isolating network itself — that needs the cloud path,
    noted in the backlog.
    Claude-Session: https://claude.ai/code/session_01GRu7Us7N5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
2026-11-04 v1.18.0: EverFlo recalibrated at Norrgården; vertical gate 20 -> 15
    The EverFlo is back at a new place and every older reference refused it
    (registration 0.55). Three sweeps, 2026-11-04: -tak (ceiling lamp, carries
    the curve), -dag (lamp off, afternoon; reference shifted onto 'tak' by its
    ticks and edges) and -natt (curtains drawn; builds nothing, the independent
    check). Geometry from a grid (band 291..305, lean 0.035, anchor 310..330);
    curve fitted to -tak with 1 L/min weighted 4x (the bottom is compressed).
    Means 0.039 / 0.035 / 0.047. Bottom state "Under 0,5", Max at y 175.
    The seven older EverFlo references are removed; their sweeps stay with
    every frame allowed to refuse and any readin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
2026-11-05 v1.18.1: EverFlo morning reference 'morgon', ball masked out
    From 09:02 UTC on 2026-11-05 most frames at Norrgården were "Osäker":
    morning daylight, which no sweep covers (registration 0.90-0.92 against
    'tak', ambiguity ~2x), with the stronger candidate the ball. Reference
    'morgon' built from the uploads 12457-12481: aligned to 'tak', median,
    again against the median, with the ball masked out of each frame first —
    17 of 25 uploads had it at y 255-295 and a plain median kept a ghost ball
    that read the sweeps 0.1 off (review). Ticks and edges within 0.35 rows /
    1.3 columns of 'tak', so no shift. All 52 uploads since 1.18.0: 14 unsure
    -> 0, the rest within 0.08 of what 'tak' read; no readin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
2026-11-06 v1.18.2: EverFlo reference 'hagtorp' for the move back to Hagtorp
    The EverFlo moved back to Hagtorp on 2026-11-06. The unit is mounted on the
    machine, so the camera kept nearly the Norrgården pose (dx -3, dy +5.7) and
    the curve and geometry are kept, but the light did not: the references
    registered 0.77-0.79 and 12 of 14 frames of a day sweep were "Osäker". New
    sweep test/everflo-sweep-2026-11-06-hagtorp-dag and reference 'hagtorp',
    aligned and shifted (-3, +4) onto 'tak' as its labels choose: mean 0.041,
    worst 0.10. Live frames read at registration 0.99, 24-32x. Every other set
    reads the same; old poses and other machines still refuse.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
2026-11-06 v1.18.3: EverFlo reference 'hagmork' (Hagtorp, lamps off)
    A sweep at Hagtorp as dark as the day allows (lamps off, blind down). The
    four references read it already, but thinly (registration 0.81-0.86,
    ambiguity down to 3.0x). New reference 'hagmork', aligned and shifted
    (-3, +4) onto 'tak' like 'hagtorp' (one pose, minutes apart): mean 0.056,
    worst 0.12, registration 0.98-0.99. Live frames read via it at 0.99, 16-18x.
    Every other set reads the same; old poses and other machines still refuse.
    Claude-Session: https://claude.ai/code/session_01GRu7Ust87MheSmJJTv9YGD
2026-11-07 v1.18.4: EverFlo night reference 'hagnatt' (Hagtorp, from uploads)
    Both nights at Hagtorp went to 'dag' (Norrgården's afternoon) at
    registration 0.91-0.94 and ambiguity 1.5-3x: 47 frames "Osäker", the
    stronger candidate the ball by the operator's check. Reference 'hagnatt'
    from the 66 night uploads 12701-12754 and 12873-12884: aligned against
    'hagmork', median, again against the median, ball masked out (no ghost:
    the profile is the same at mask 24/32/40). Not shifted: ticks within
    0.4 rows of 'hagmork', same pose. Held out: odd ids 13/33 -> 33/33. All
    258 uploads since 1.18.2: 47 "Osäker" -> 8 (evening, 'hagtorp'), night
    readings 0.03-0.04 lower than 'dag' gave, level with tak/hagtorp/hag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
2026-11-08 v1.18.5: EverFlo evening reference 'hagkväll' (Hagtorp, from uploads)
    From dusk with the lamps on the frames went to 'hagtorp', a daylight
    sweep, at registration 0.92-0.95 and ambiguity 1.4-3x: 27 "Osäker" on
    2026-11-08 and 7 on the two evenings before, the stronger candidate the
    ball by the operator's check. Reference 'hagkväll' from the 48 uploads
    12990-13037 of 11-08: aligned, median, again, ball masked (no ghost at
    mask 24/40), no shift (ticks within 0.7 rows of 'hagtorp'). The two
    earlier evenings are unused and read 78/78 at 4.5x or better. All 408
    uploads since 1.18.2: 35 "Osäker" -> 1, nothing moved over 0.03. Forced
    onto the labelled Hagtorp day sweep it reads 1..4.5 within 0.11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
